devATdbsutdio/watch_hardwares/README.md

# watch_hardwares
PCB files and 3D files from each products and tools designed for the watch project, as exported from fusion360

License: [Apache License](https://github.com/devATdbsutdio/watch_hardwares/blob/main/LICENSE)
