devATdbsutdio/watch_hardwares/watchpcb/README.md

# Main PCB for the LED watch : Version 3

Contains exported CAE design files (schematic & board files) and CAD PCB files from fusion 360.

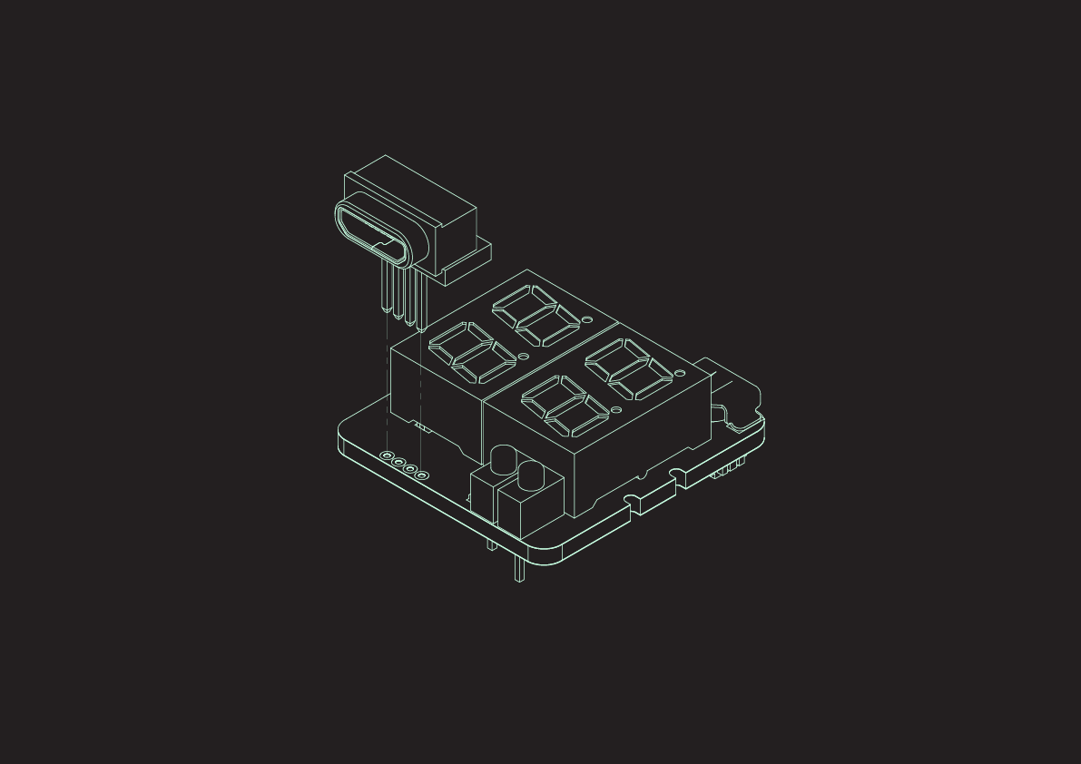
[picture p1: watchpcb/assembly_diagram.png]
assembly


## Special Notes:
* Uses CH343N as serial chip.
* Uses Separate USB module on a Raiser board. 
* Micro usb for Serial port and LiPo charging. 
* UPDI programming pins are broken out in the bottom.
