devATdbsutdio/watch_hardwares/user_programmer/README.md

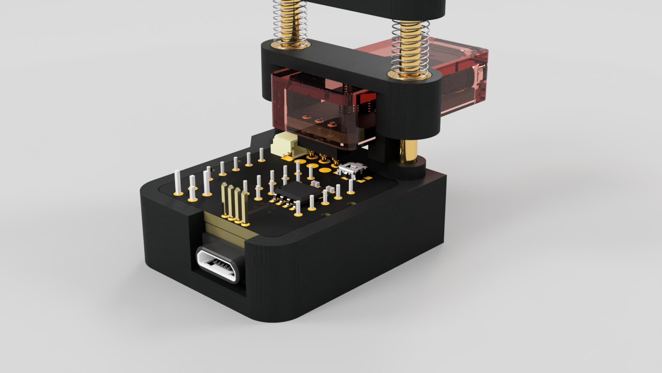
[picture p2: user_programmer/images/firmware_uploader.png]
watchinjig

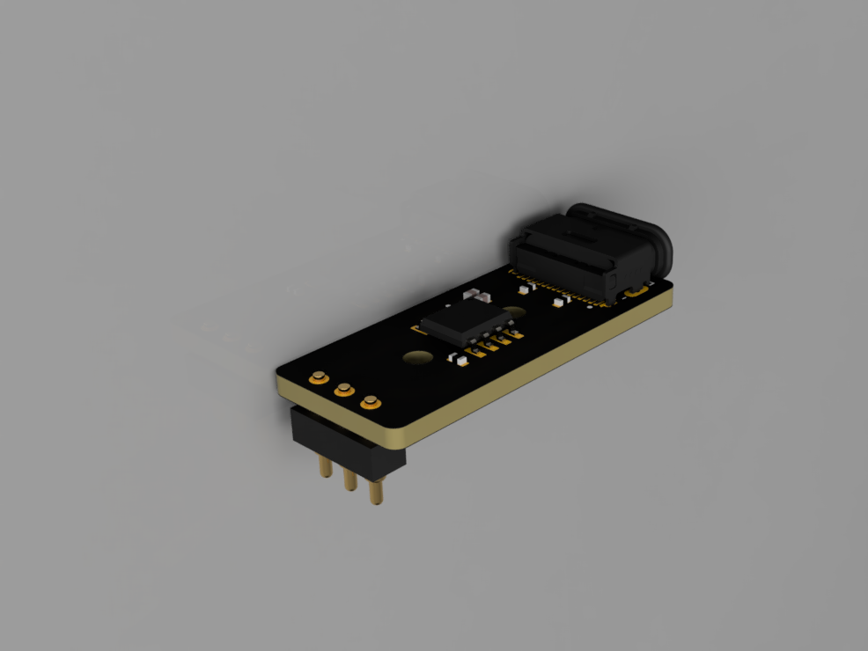
[picture p3: user_programmer/images/user_prog_pcb_top.png]
top

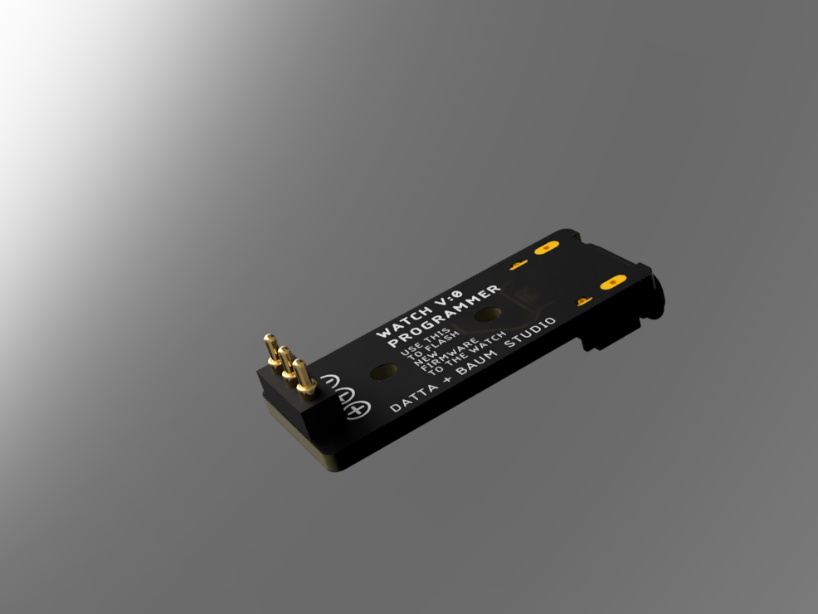
[picture p4: user_programmer/images/user_prog_pcb_bottom.png]
bottom

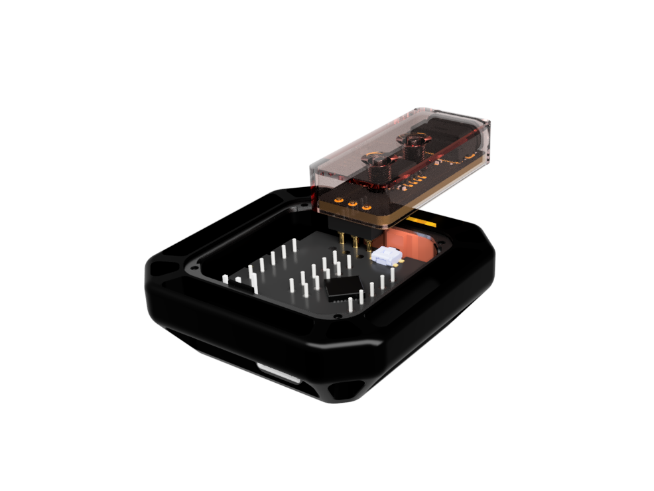
[picture p5: user_programmer/images/prog_on_watch.png]
onwatch
