devATdbsutdio/watch_hardwares/watchpcb/watch_pcb_v3/README.md

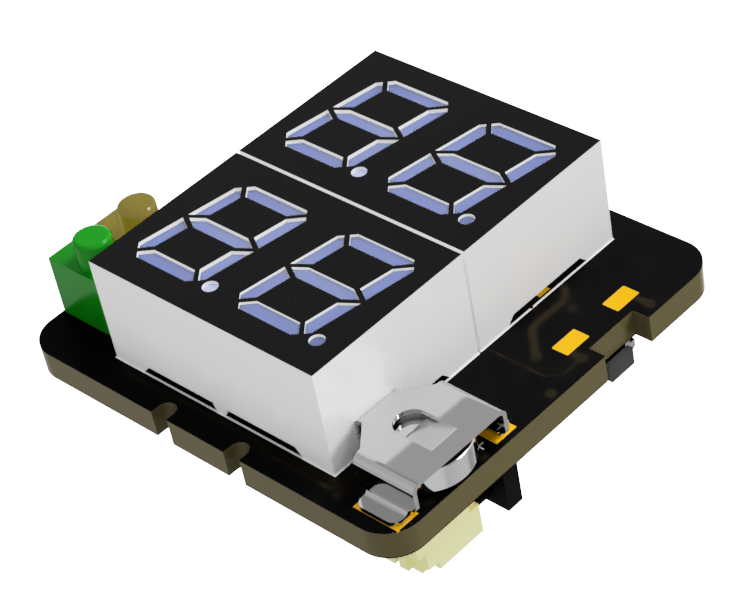
[picture p6: watchpcb/watch_pcb_v3/images/watch_pcb_top_s.png]
top

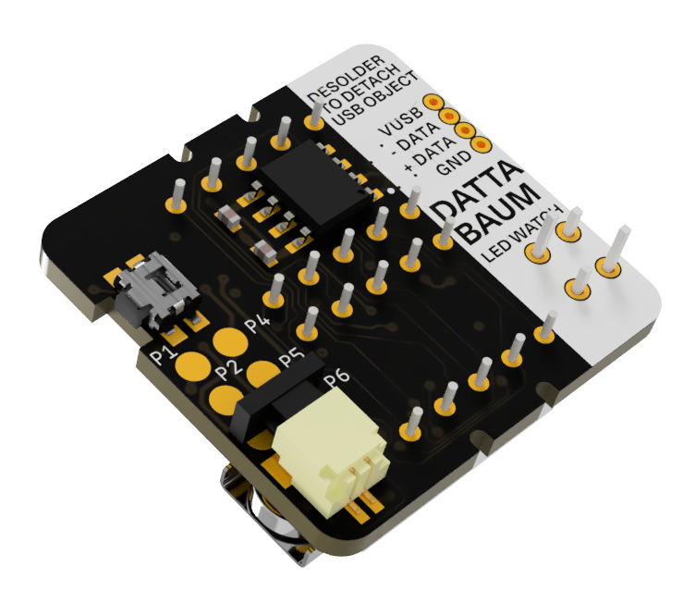
[picture p7: watchpcb/watch_pcb_v3/images/watch_pcb_bottom_s.png]
bottom
