devATdbsutdio/watch_hardwares/watchpcb/raised_usb_module/README.md

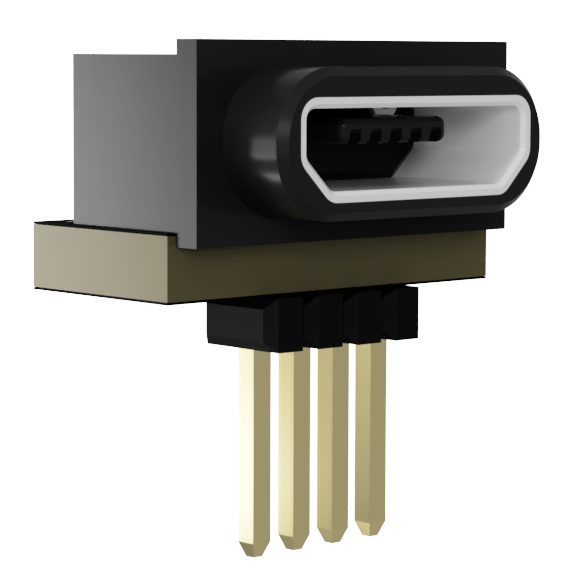
[picture p8: watchpcb/raised_usb_module/images/HOR_water_tight_microUSB_raiser1.png]

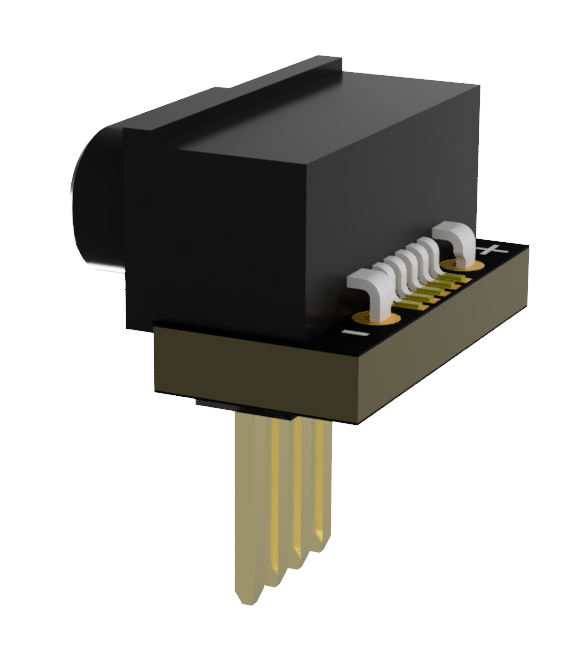
[picture p9: watchpcb/raised_usb_module/images/HOR_water_tight_microUSB_raiser2.png]
