devATdbsutdio/watch_hardwares/user_programmer/images/firmware_uploader_textured.png

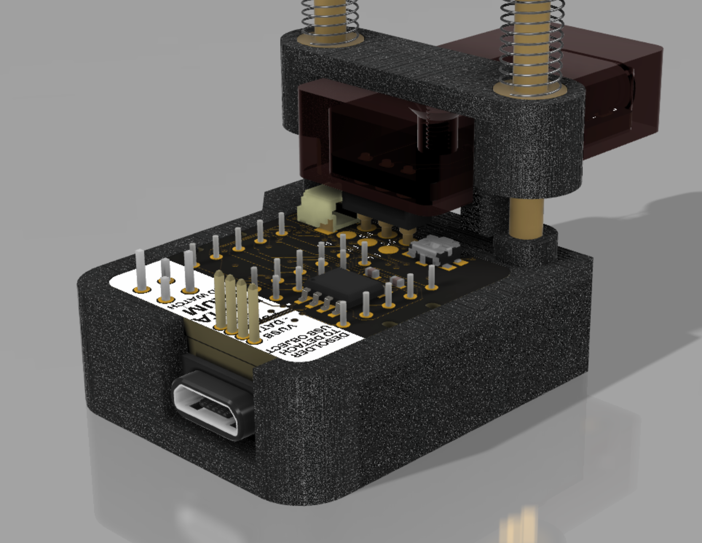
user_programmer/images/firmware_uploader_textured.png
