devATdbsutdio/watch_hardwares/watchpcb/watch_pcb_v3/images/stackup.png

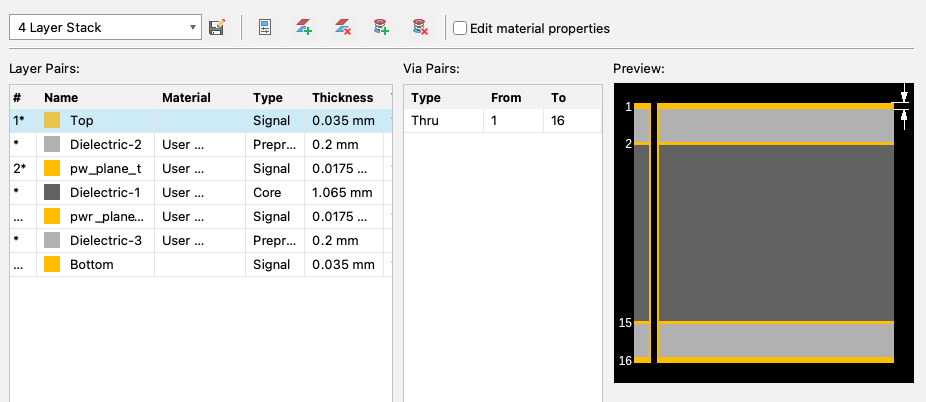
watchpcb/watch_pcb_v3/images/stackup.png
