devATdbsutdio/watch_hardwares/user_programmer/BOM/user_programmer v11.xlsx

user_programmer v11
Part | Value | Device | Package | Description | CATEGORY | MANUFACTURER | MF
C3 | 100nF | C_CHIP-0402 | C0402 | Capacitor - Generic | Capacitor
C4 | 100nF | C_CHIP-0402 | C0402 | Capacitor - Generic | Capacitor
R1 | 4.7K | R-US_CHIP | R0402 | Resistor Fixed - ANSI | Resistor
U$1 | 1X3_POGO_PIN_HOLDER | H093 | 3P-2.5-1.5 | Pogo pins | Pogo | https://item.taobao.com/item.htm?spm=a1z09.2.0.0.85152e8dntbOOL&id=635234737359&_u=42q42hct8c07
U$6 | CH330N | CH330N | SOP-8 | Usb serial chip | Chip
X1 | MICRO_USB | MICRO_USB | SMD | Micro USB Type B Connector - Standard, Shell Through Hole | USB | https://lcsc.com/product-detail/USB-Connectors_Jing-Extension-of-the-Electronic-Co-920-E52A2021S10100_C10418.html
