devATdbsutdio/watch_hardwares/programming_and_testing_jig/3D/LockHinge v2.step

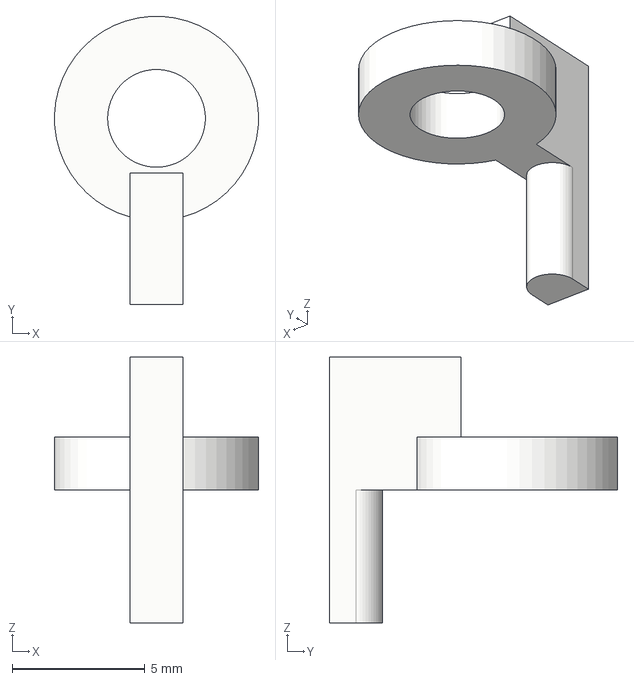
[picture p12: CAD file, 2022-06-01]
programming_and_testing_jig/3D/LockHinge v2.step
7.67 x 10.8 x 10.0 mm
