devATdbsutdio/watch_hardwares/user_programmer/3D/micro_usb_version_prog_shell.step

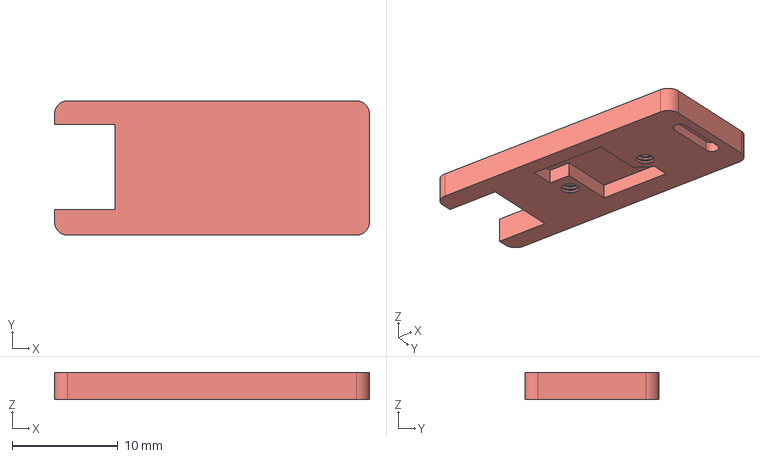
[picture p13: CAD file, 2022-06-10]
user_programmer/3D/micro_usb_version_prog_shell.step
29.7 x 12.7 x 2.55 mm
