devATdbsutdio/watch_hardwares/watchpcb/raised_usb_module/3D/HOR_water_tight_microUSB_raiser.step

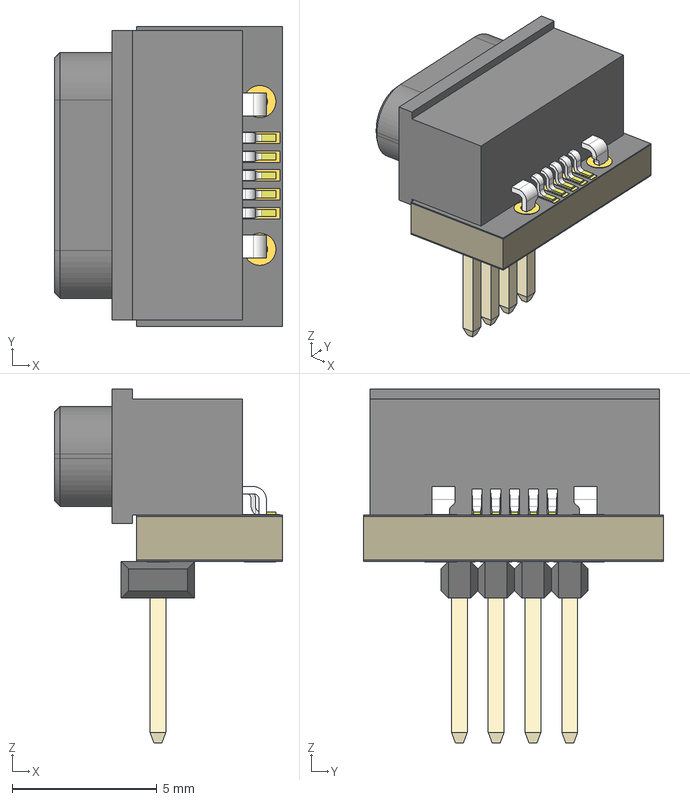
[picture p14: CAD file, 2022-04-22]
watchpcb/raised_usb_module/3D/HOR_water_tight_microUSB_raiser.step
7.89 x 10.4 x 12.2 mm
Board
CUI_DEVICES_UJ2-MIBH-4-SMT-TR-67 v1
1-copper
16-copper
1-soldermask
16-soldermask
