devATdbsutdio/watch_hardwares/package interior foam /box in foam 350x300x130.step

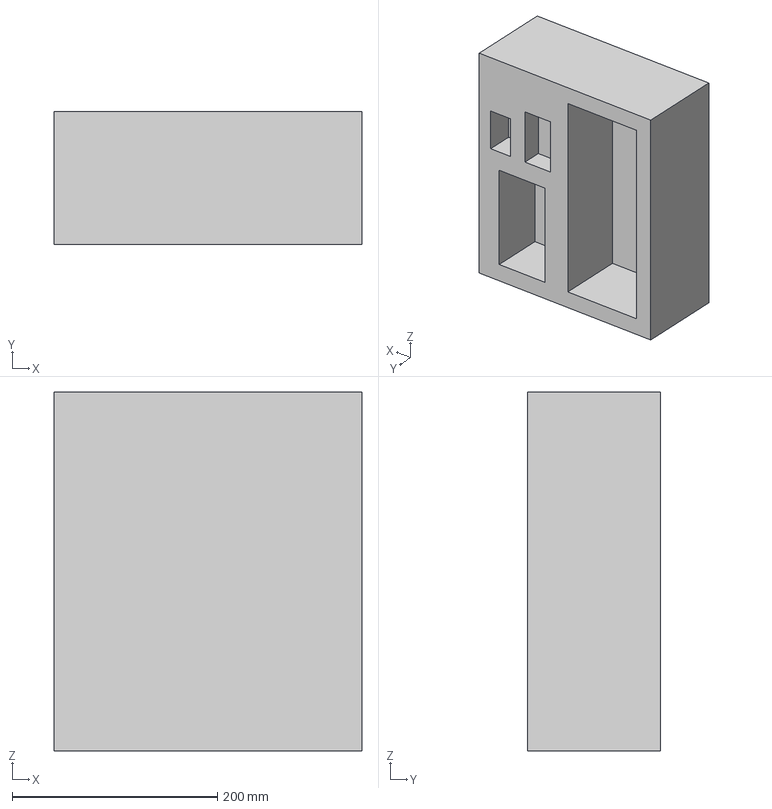
[picture p15: CAD file, 2022-05-25]
package interior foam /box in foam 350x300x130.step
300.0 x 130.0 x 350.0 mm
