devATdbsutdio/watch_hardwares/programming_and_testing_jig/3D/TopFrame v2.step

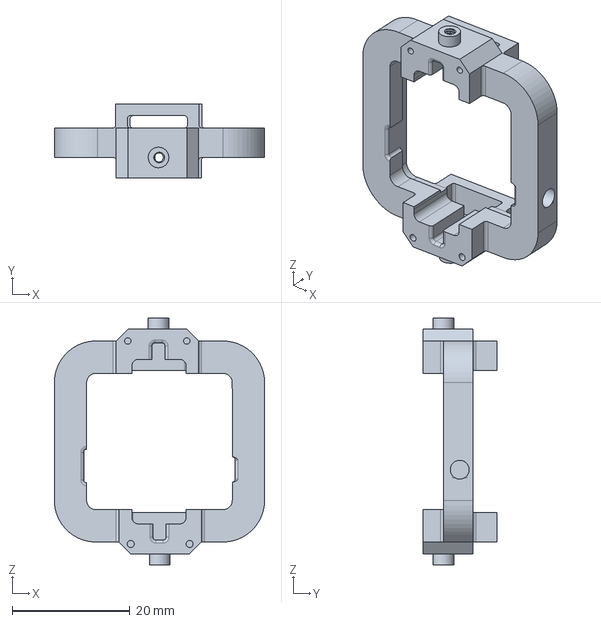
[picture p16: CAD file, 2022-06-01]
programming_and_testing_jig/3D/TopFrame v2.step
35.7 x 12.6 x 41.9 mm
