devATdbsutdio/watch_hardwares/user_programmer/3D/user_programmer_pcb.step

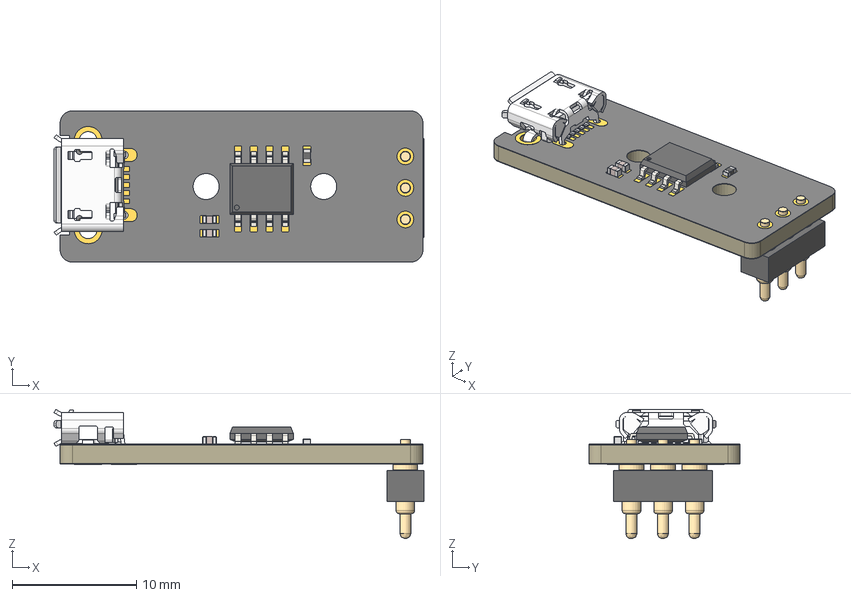
[picture p17: CAD file, 2022-06-04]
user_programmer/3D/user_programmer_pcb.step
29.8 x 12.2 x 10.4 mm
Board
microusb v2
CAPC1005X60 x 2
pogoPin x 3
pinHolder
5576505.f3d
1-copper
16-copper
1-soldermask
16-soldermask
