devATdbsutdio/watch_hardwares/user_programmer/3D/user_prog_pcb.step

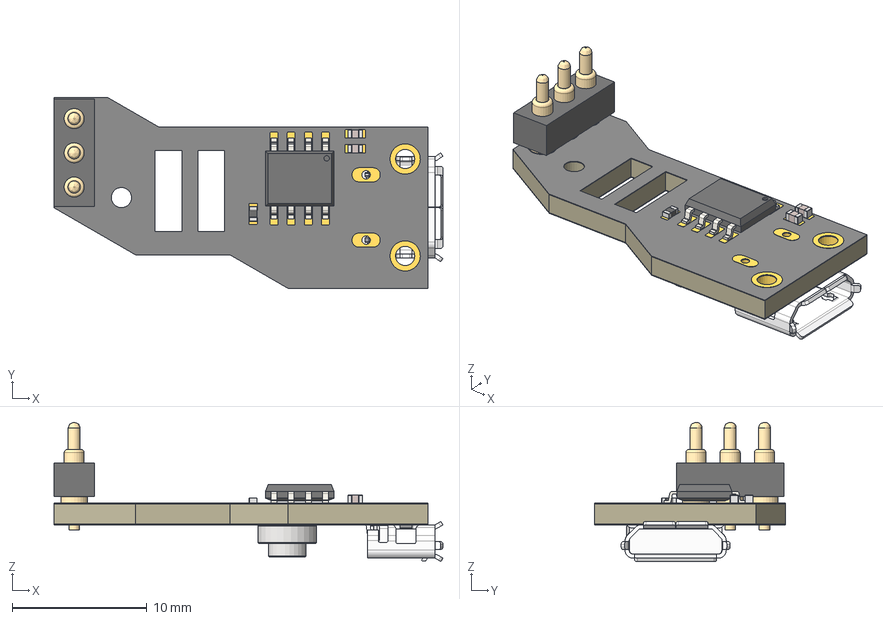
[picture p18: CAD file, 2022-04-21]
user_programmer/3D/user_prog_pcb.step
28.9 x 14.2 x 10.3 mm
Board
1-soldermask
16-soldermask
M2X2.4SMT_STANDOFF
CAPC1005X60 x 2
pogoPin x 3
pinHolder
microusb v2
5576505.f3d
1-copper
16-copper
