devATdbsutdio/watch_hardwares/programming_and_testing_jig/3D/Base.step

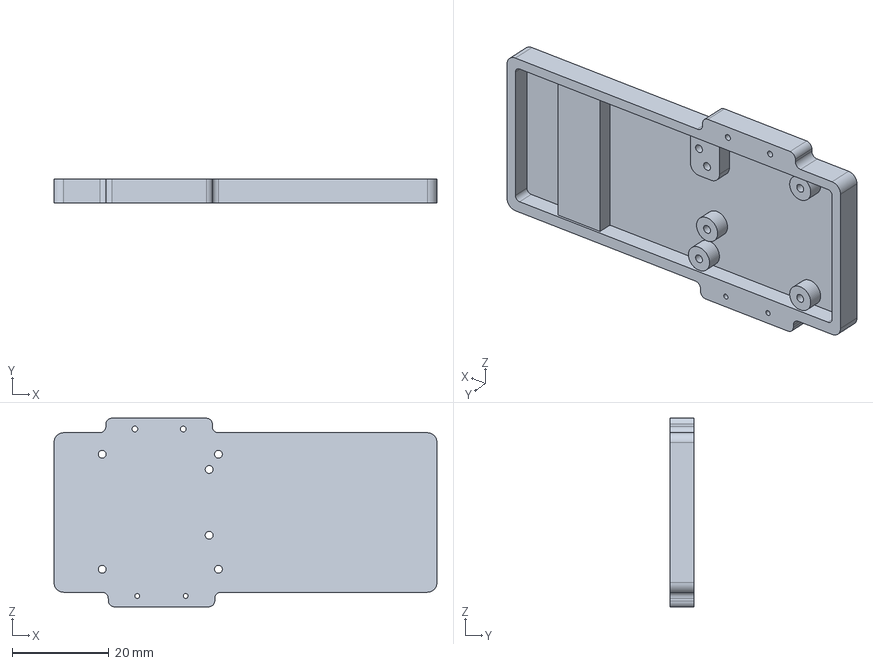
[picture p19: CAD file, 2022-05-26]
programming_and_testing_jig/3D/Base.step
79.1 x 5.00 x 38.9 mm
