devATdbsutdio/watch_hardwares/programming_and_testing_jig/3D/LockHinge.step

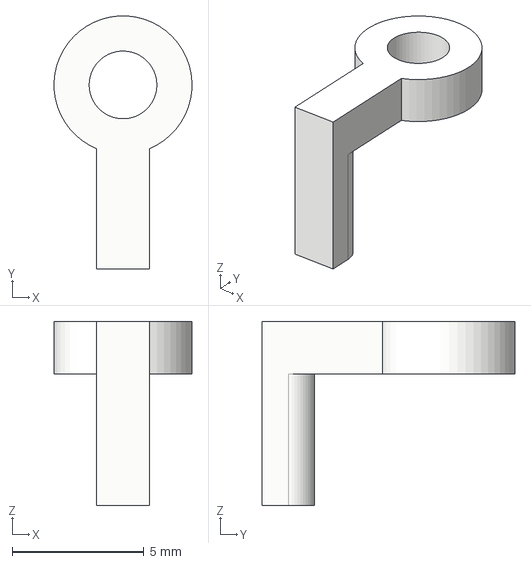
[picture p20: CAD file, 2022-05-26, an earlier design]
programming_and_testing_jig/3D/LockHinge.step
5.25 x 9.62 x 7.00 mm
