devATdbsutdio/watch_hardwares/programming_and_testing_jig/3D/TopFrame.step

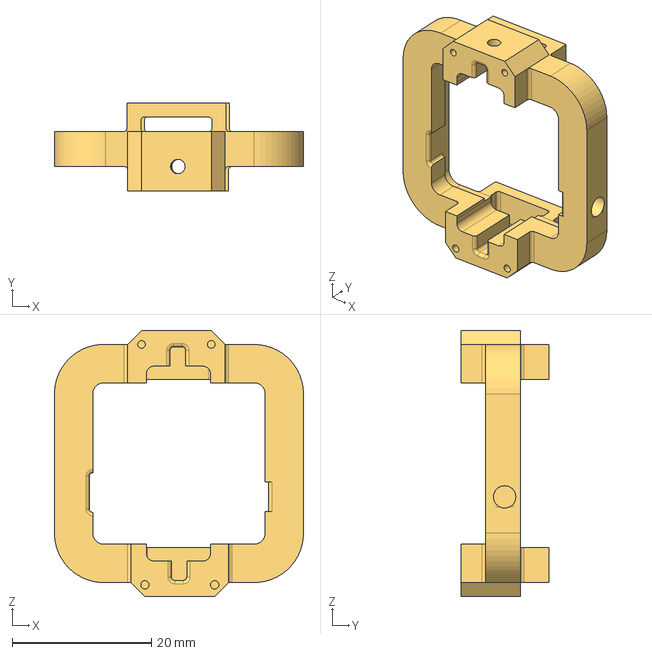
[picture p21: CAD file, 2022-05-26, an earlier design]
programming_and_testing_jig/3D/TopFrame.step
35.7 x 12.6 x 38.1 mm
