devATdbsutdio/watch_hardwares/(list of files, cad)

Other CAD files:
package interior foam /box in foam 350x300x130.dxf
package interior foam /foam PCB tray.dxf
programming_and_testing_jig/3D/BottmTopFrame v2.f3d
programming_and_testing_jig/3D/LockHinge v2.f3d
programming_and_testing_jig/3D/testing_jig_PCB.f3z
programming_and_testing_jig/3D/testing_jig_assembly.f3z
user_programmer/3D/HOUSING.f3d
user_programmer/3D/micro_usb_version_prog_shell.f3d
user_programmer/3D/user_prog_pcb_shell.f3d
user_programmer/3D/user_programmer_pcb.f3d
watchpcb/raised_usb_module/3D/HOR_water_tight_microUSB_raiser.f3d
