devATdbsutdio/watch_hardwares/ASSEMBLY GUIDE FOR MANUFACTURER/For ID assembler (some pcb components)/Untitled.pdf

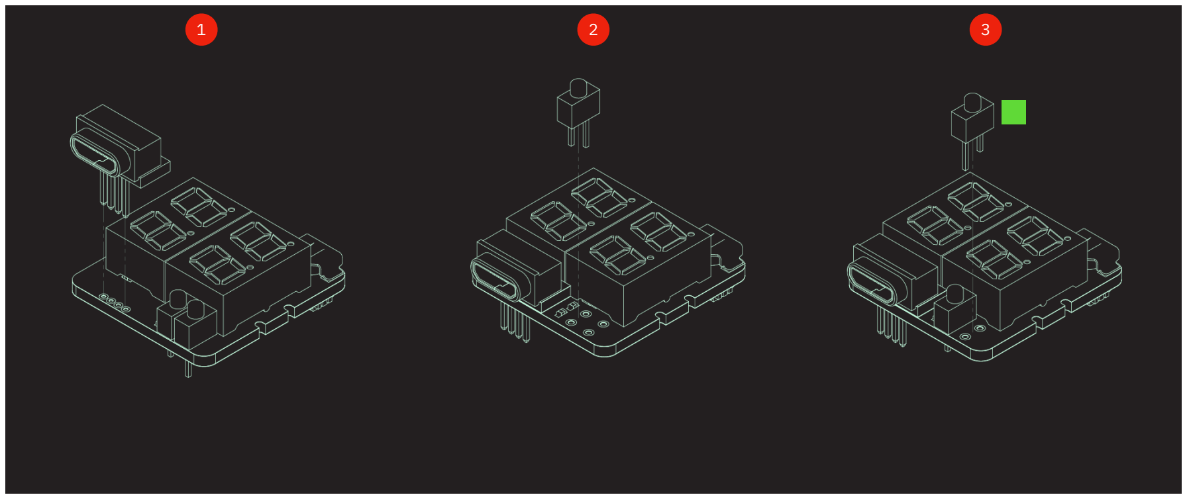
[picture p35: page 1]

1 | 2 | 3

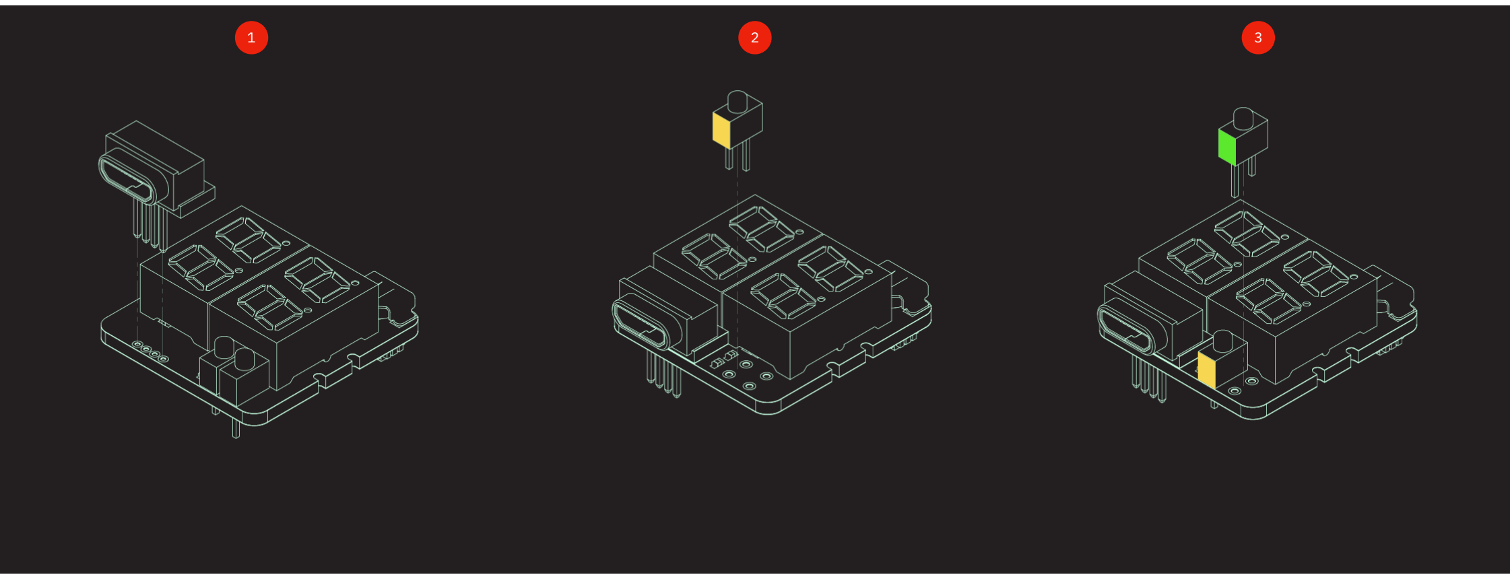
[picture p36: page 2]

1 | 2 | 3
