devATdbsutdio/watch_hardwares/ASSEMBLY GUIDE FOR MANUFACTURER/For ID assembler (some pcb components)/assembly_diagram_2.png

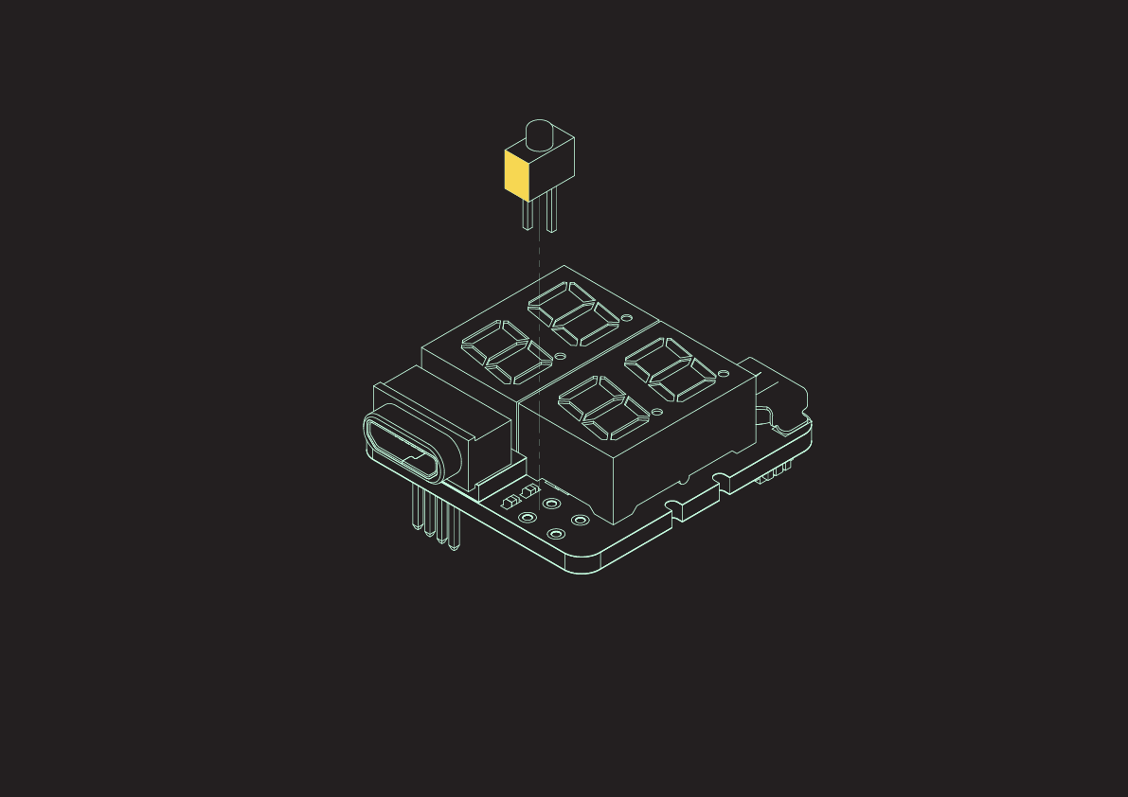
ASSEMBLY GUIDE FOR MANUFACTURER/For ID assembler (some pcb components)/assembly_diagram_2.png
