devATdbsutdio/watch_hardwares/programming_and_testing_jig/README.md

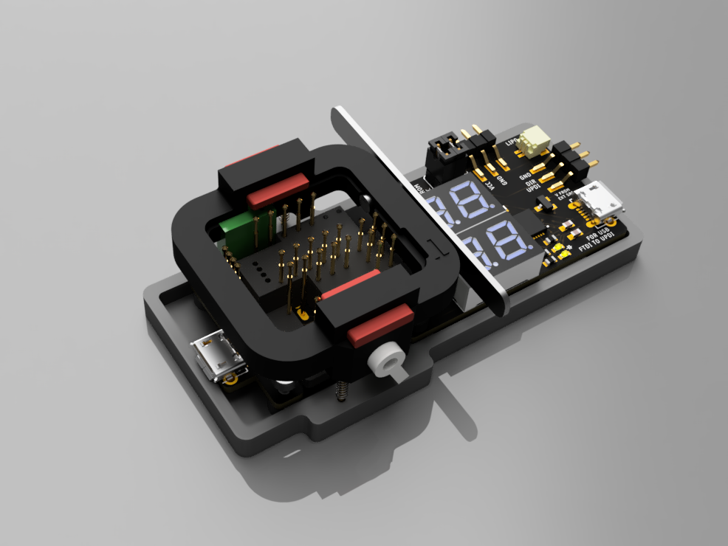
[picture p38: programming_and_testing_jig/images/component_jig_assembled.png]
top view

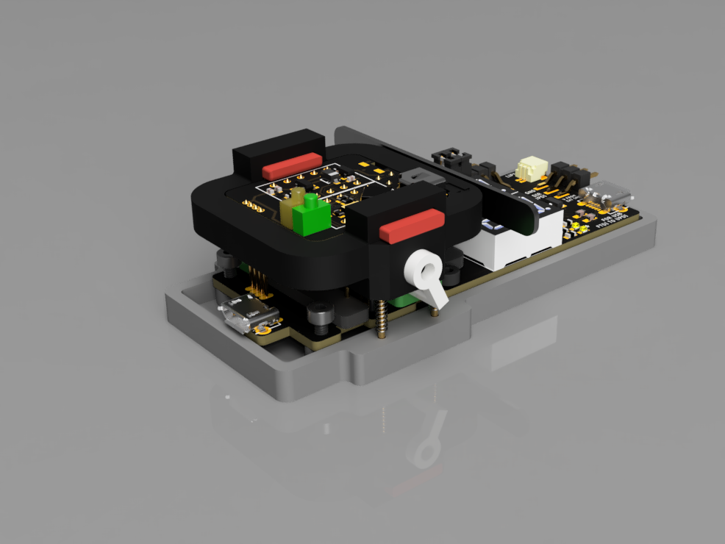
[picture p39: programming_and_testing_jig/images/assembled_test_jig_view_1.png]
side view
