devATdbsutdio/watch_hardwares/programming_and_testing_jig/images/side_view.png

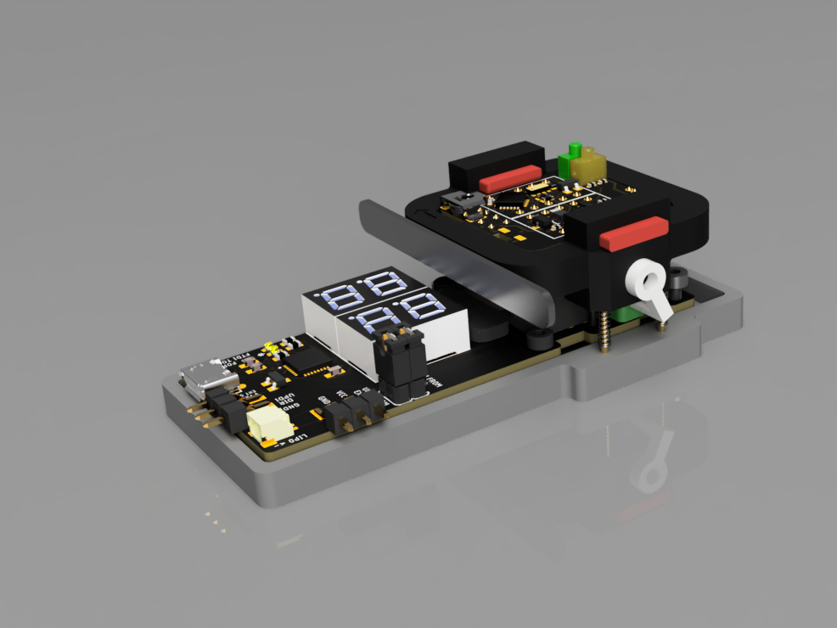
programming_and_testing_jig/images/side_view.png
