devATdbsutdio/watch_hardwares/watchpcb/assembly_diagram.pdf

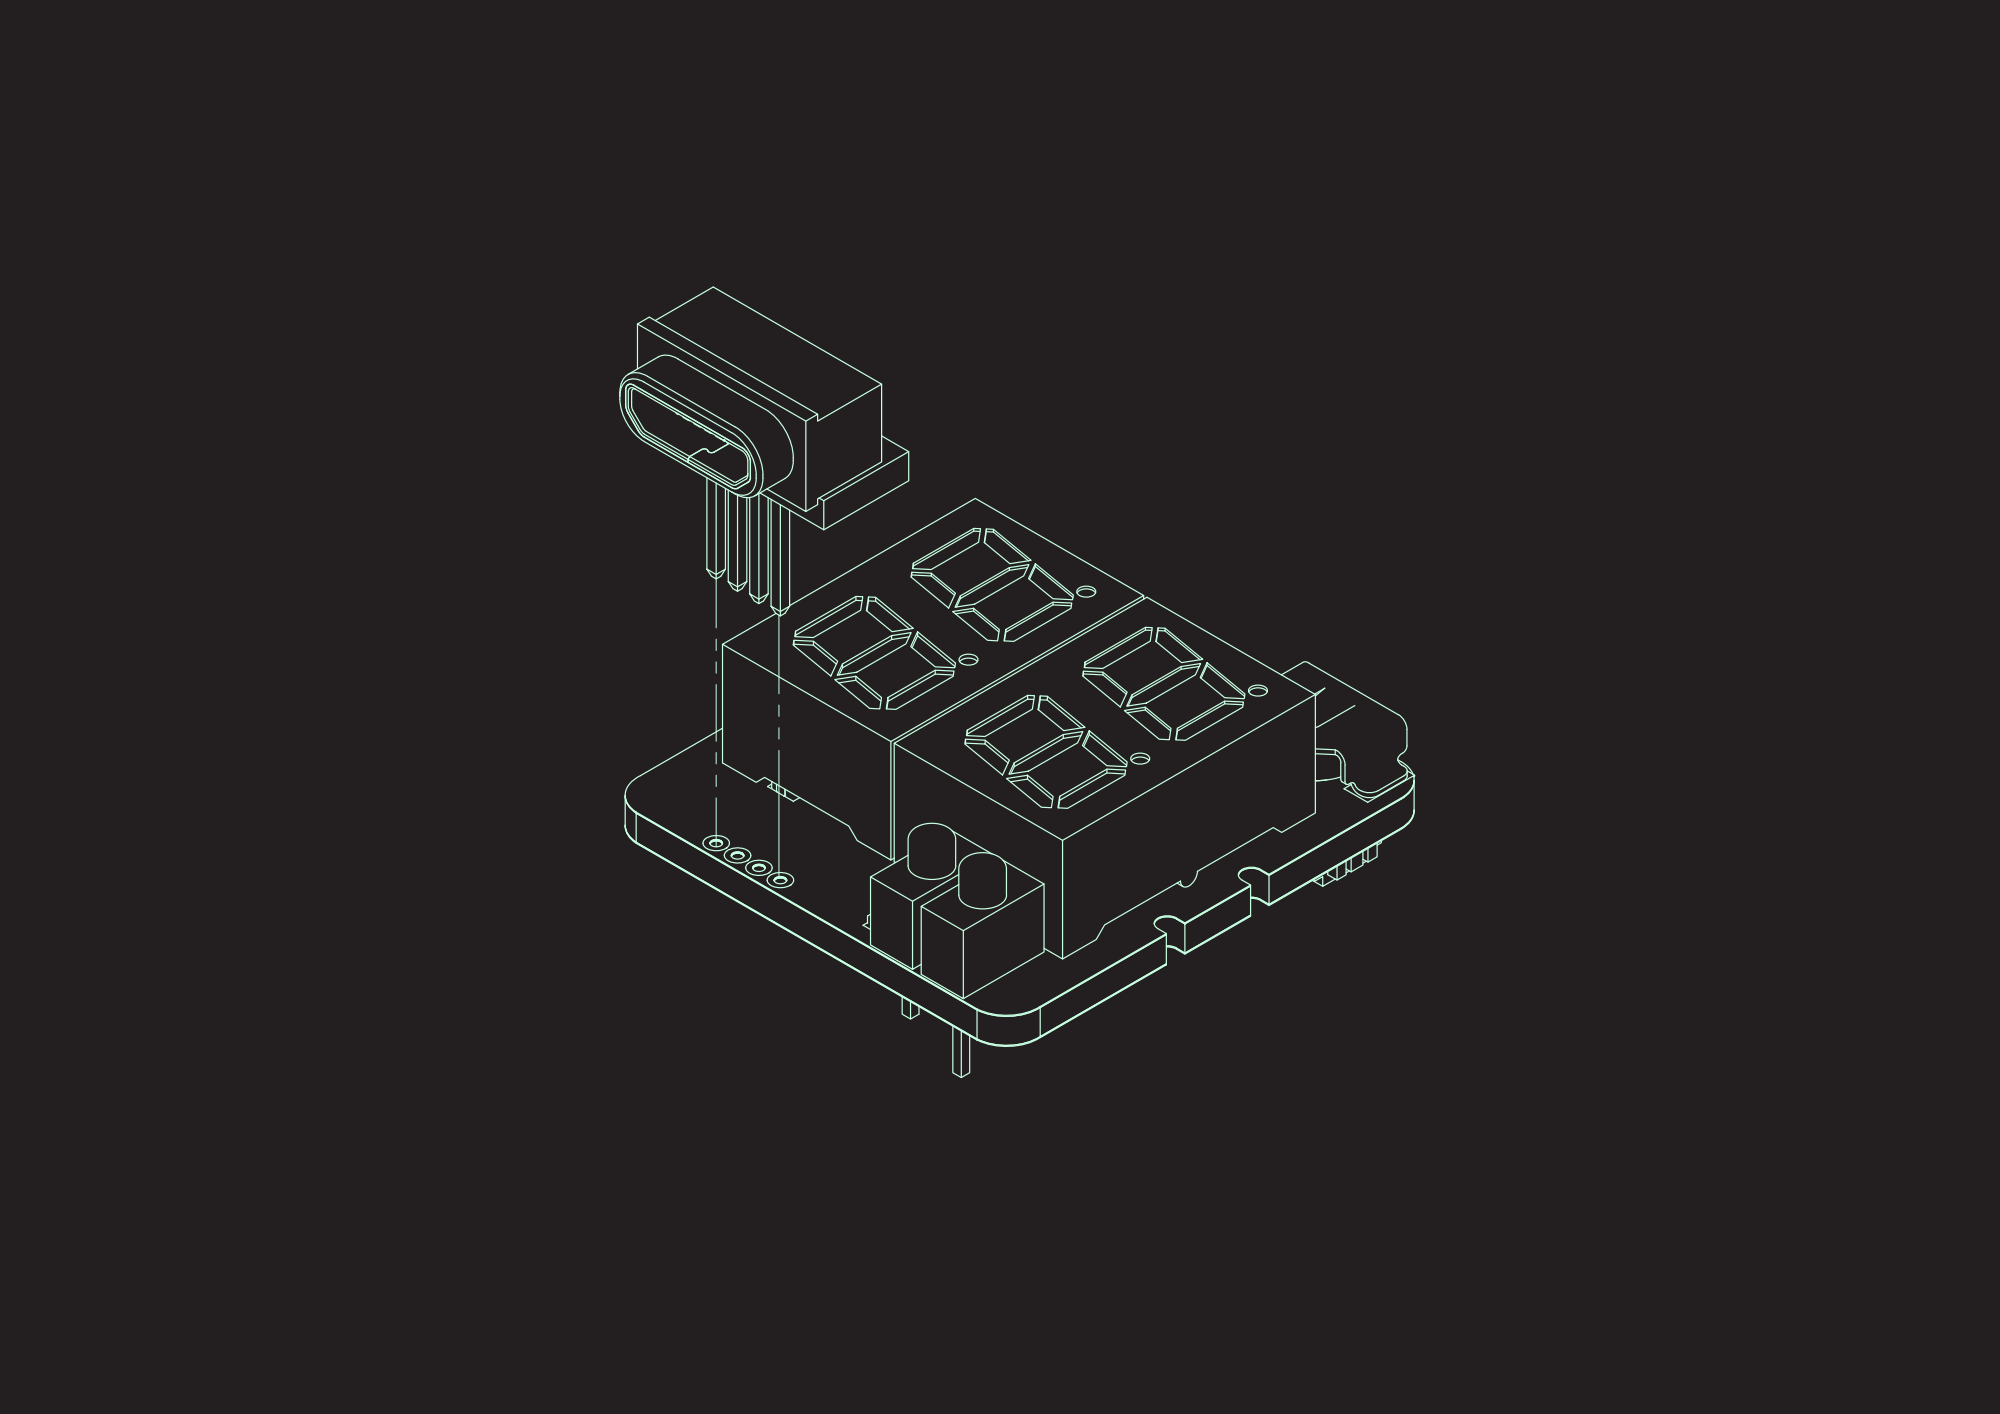
[picture p41: page 1]
