devATdbsutdio/watch_hardwares/ASSEMBLY GUIDE FOR MANUFACTURER/For ID assembler (some pcb components)/assembly1.pdf

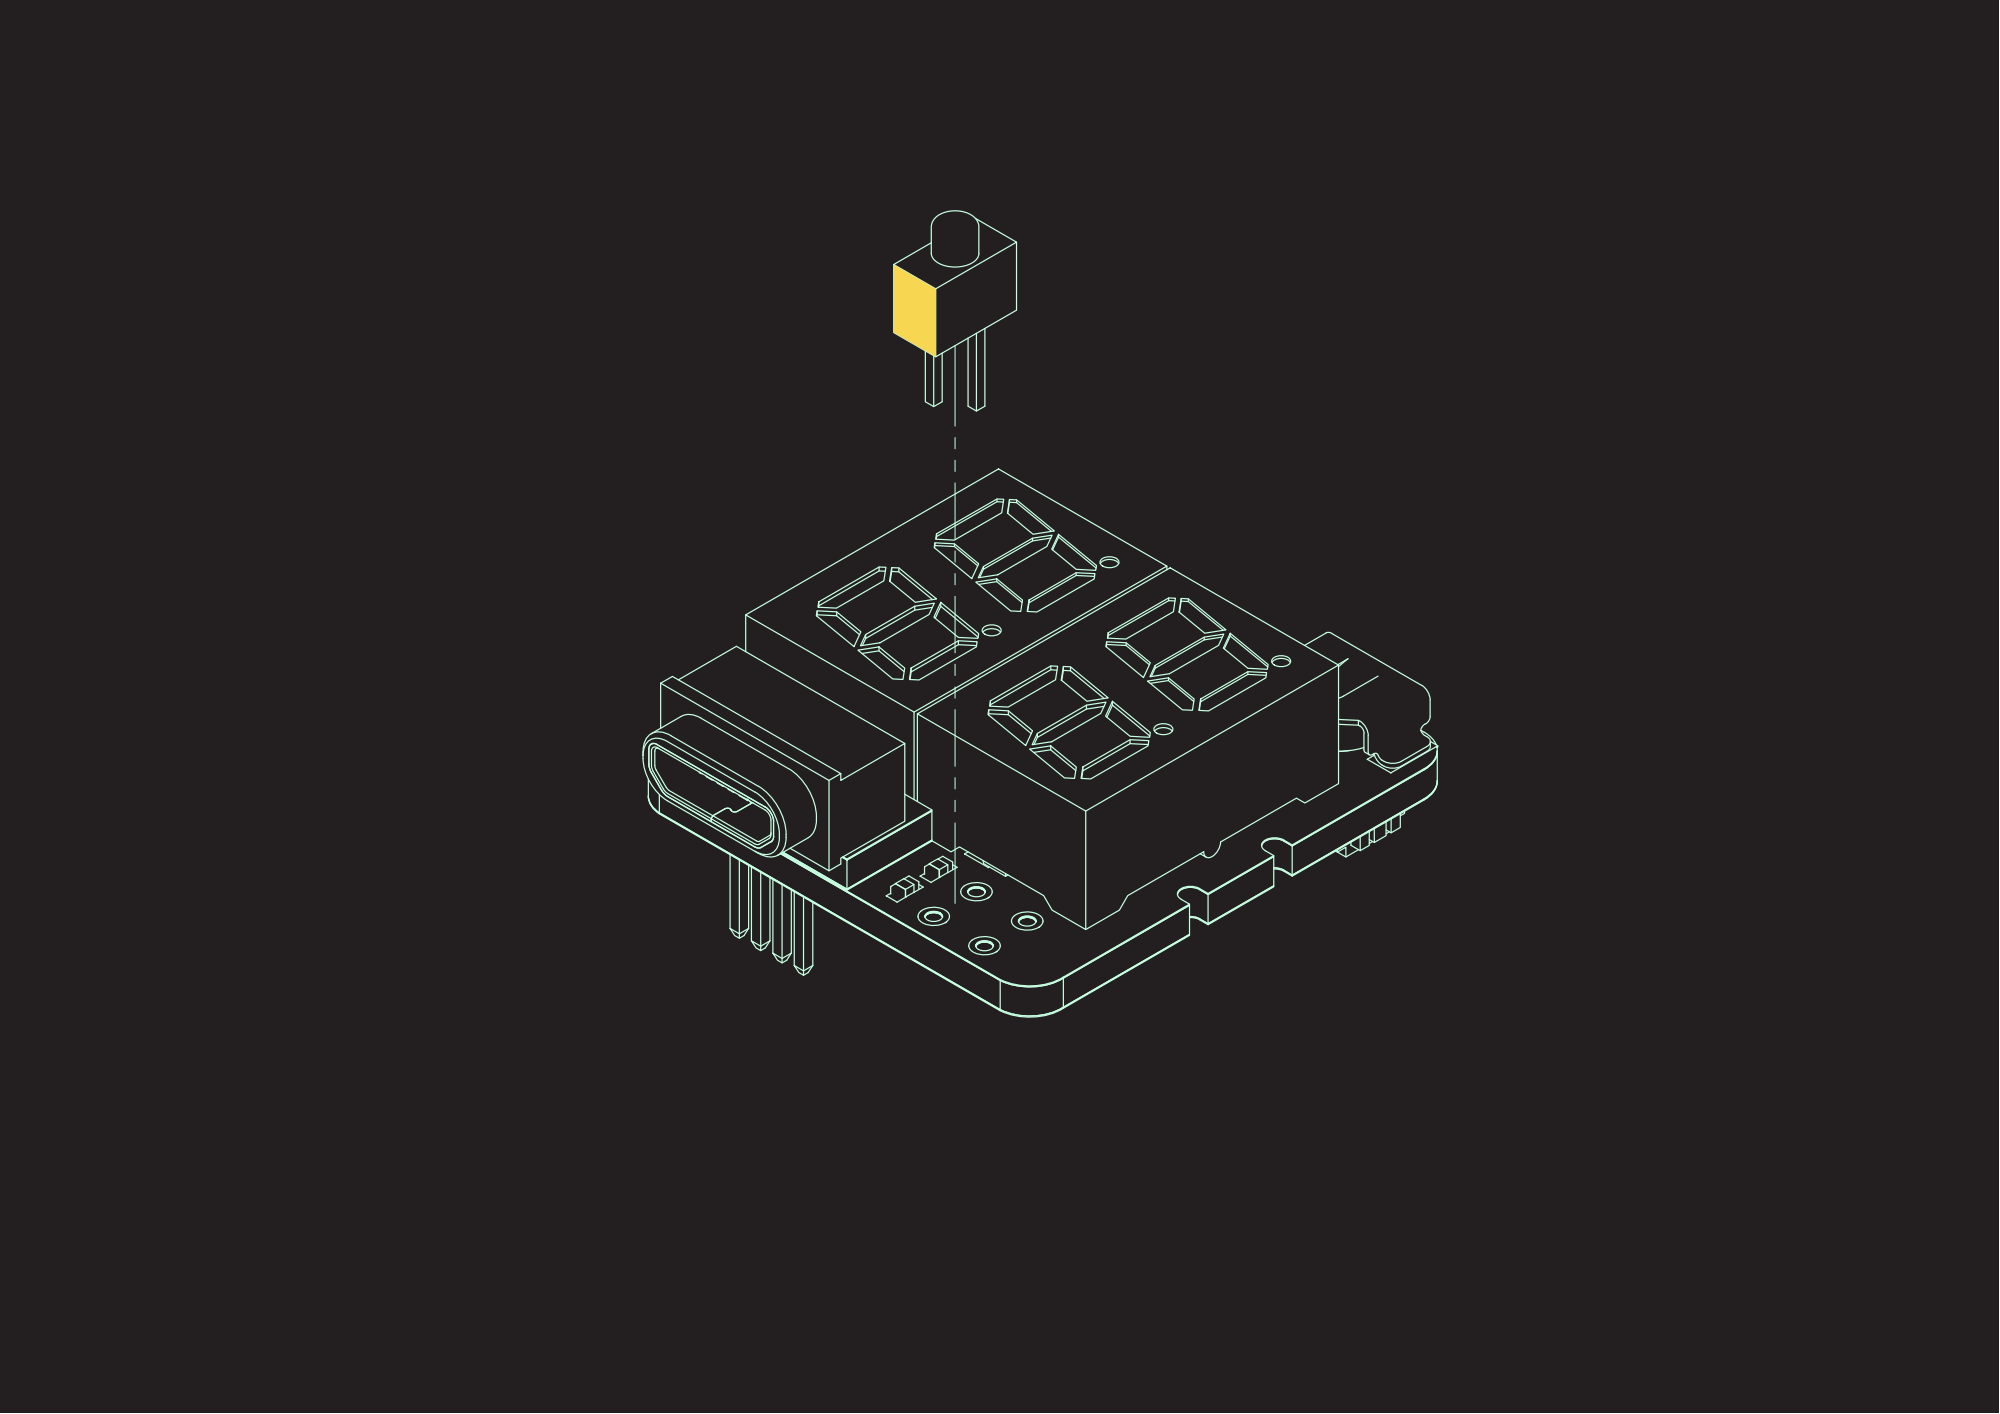
[picture p42: page 1]
