devATdbsutdio/watch_hardwares/ASSEMBLY GUIDE FOR MANUFACTURER/For ID assembler (some pcb components)/assembly2.pdf

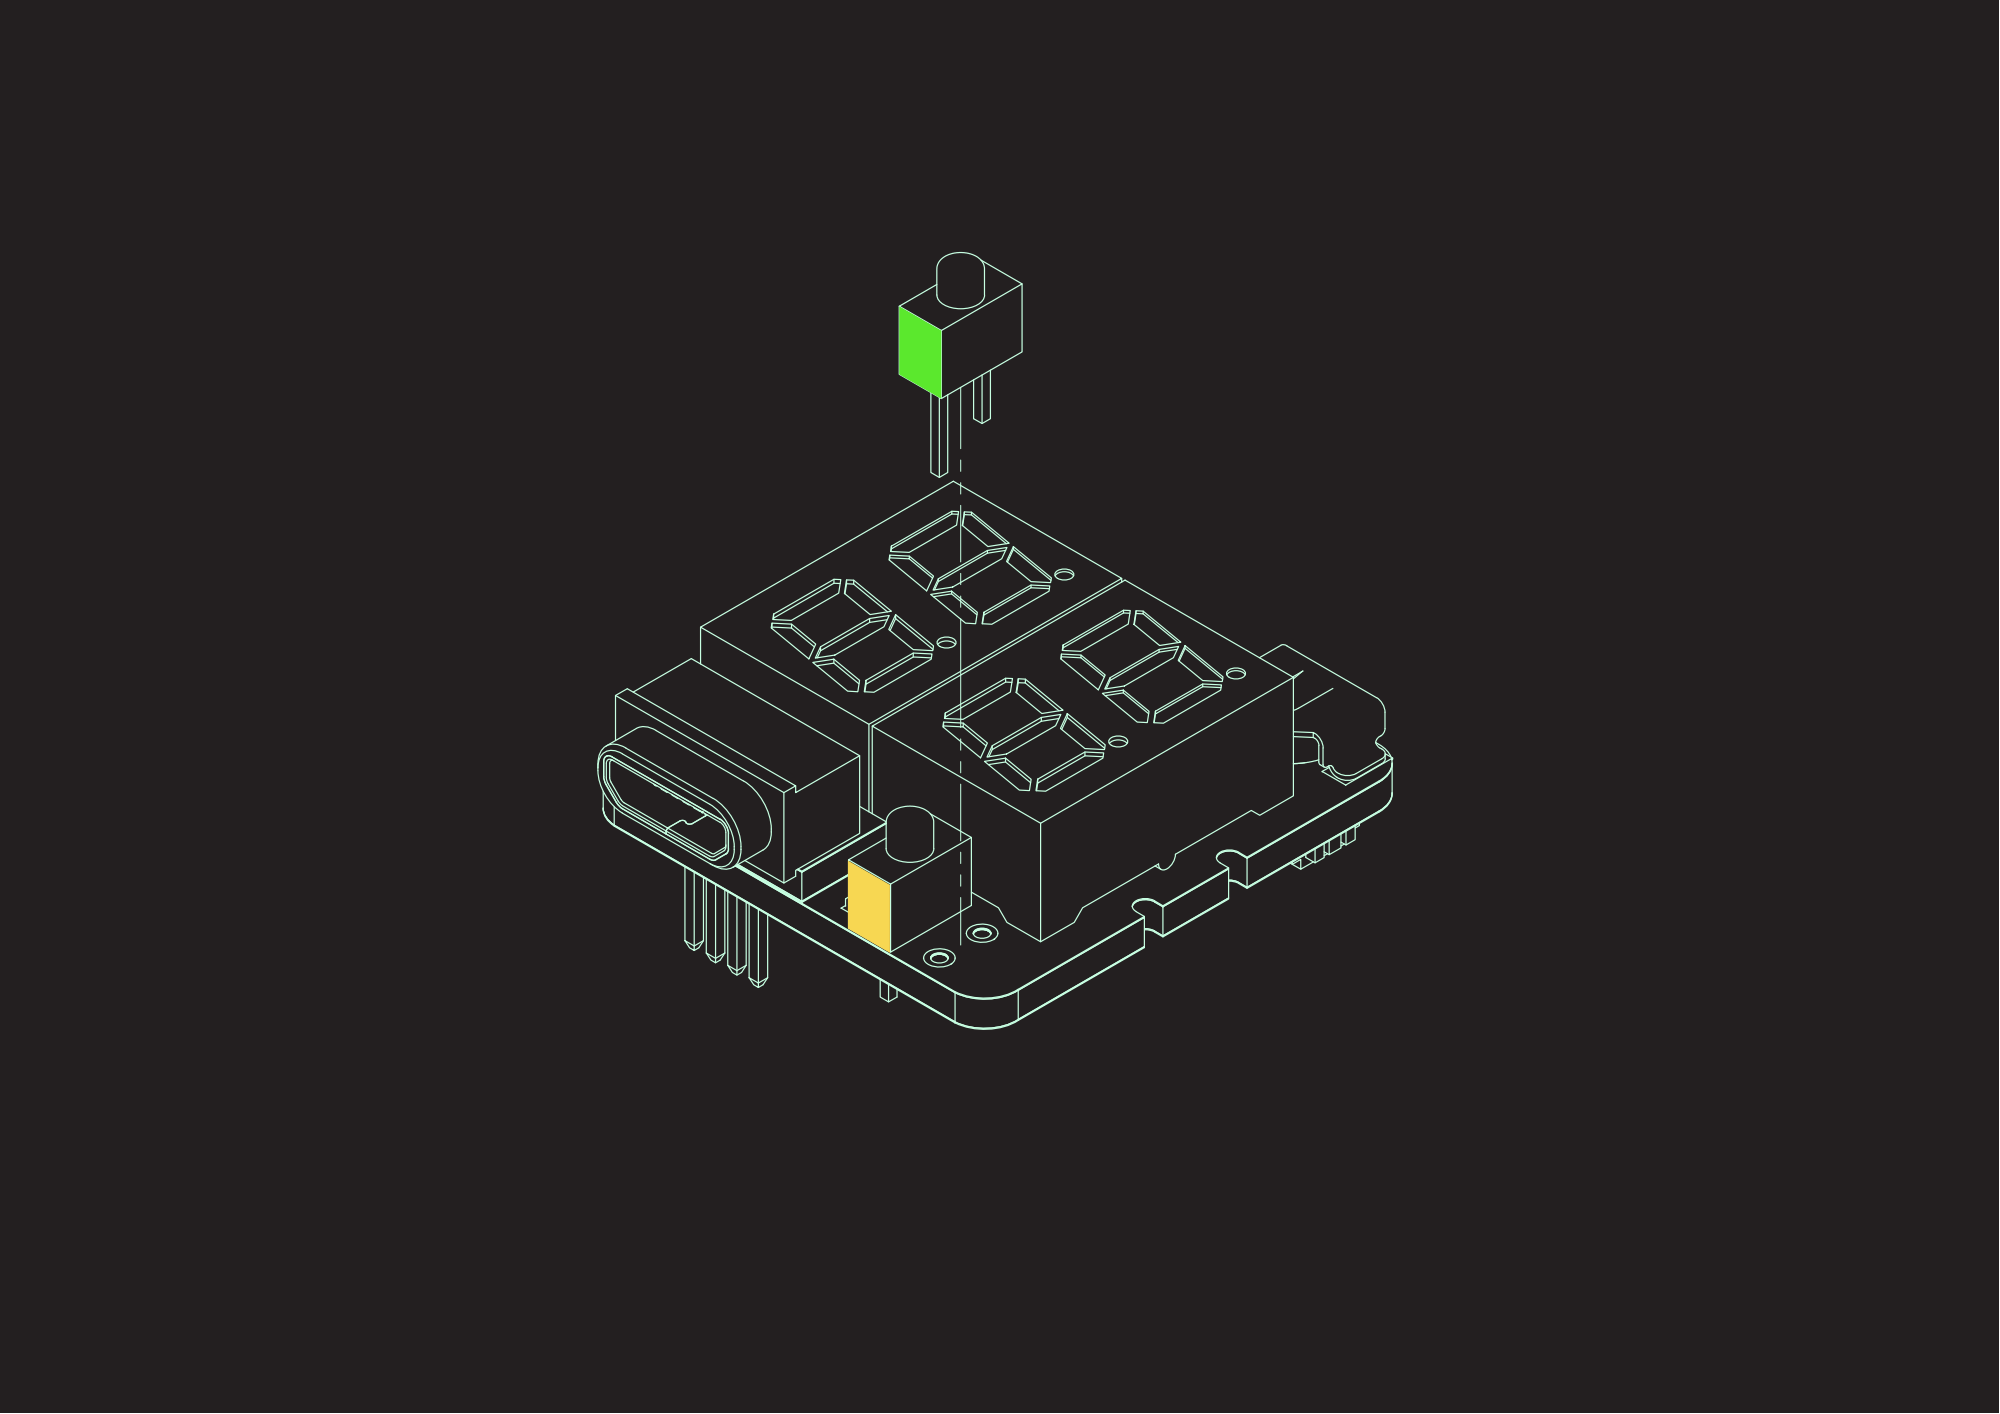
[picture p43: page 1]
