devATdbsutdio/watch_hardwares/watchpcb/watch_pcb_v3/PnP/watch_pcb_bom.pdf

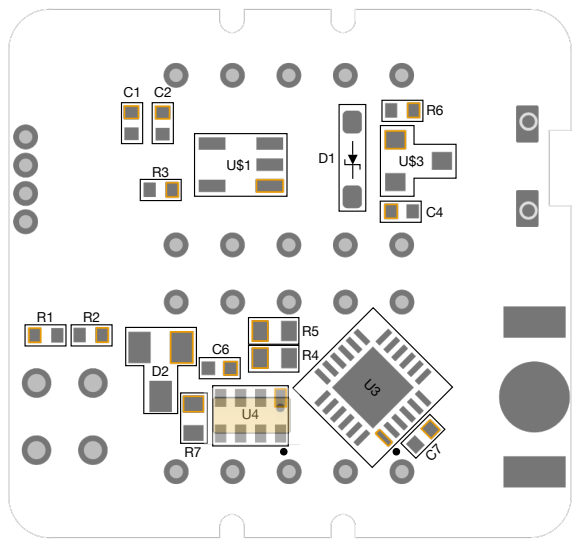
[picture p44: page 1]

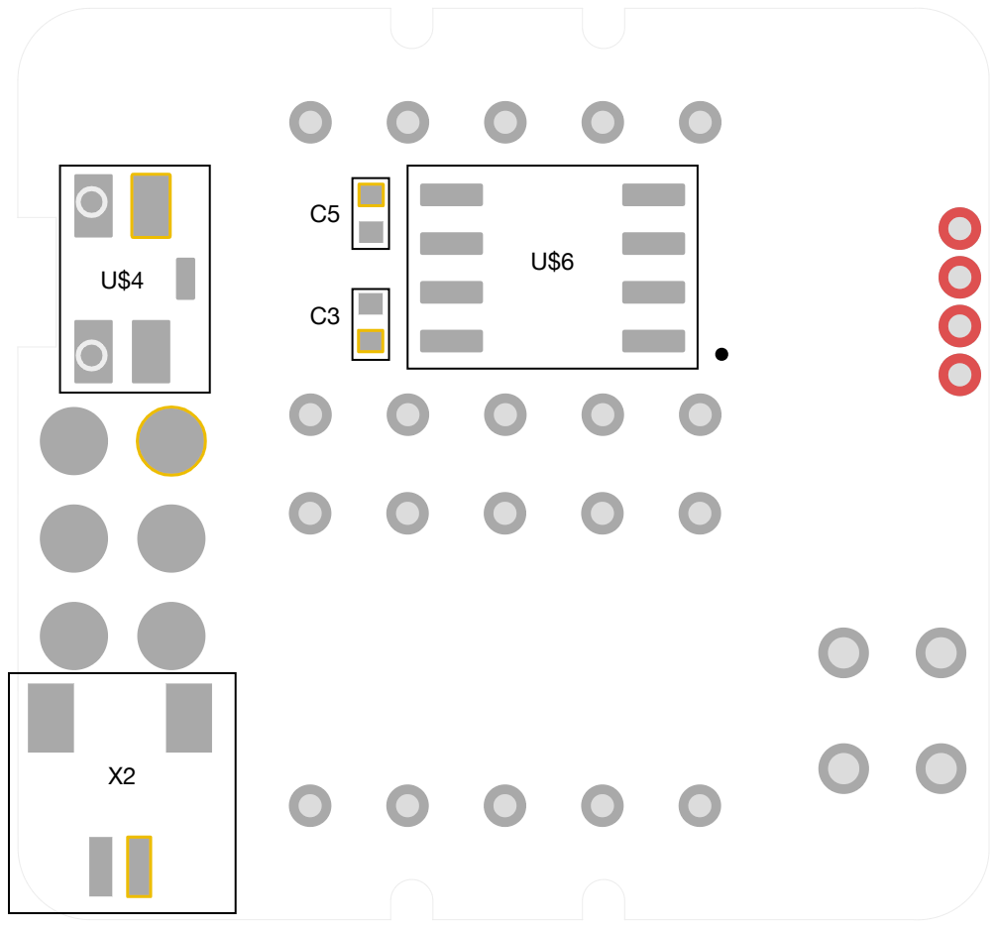
[picture p45: page 2]

U$6 U$4

X2

C5

C3
