devATdbsutdio/watch_hardwares/user_programmer/PCB_Board/user_prog_jig_pcb_v206.brd

## EAGLE design user_programmer/PCB_Board/user_prog_jig_pcb_v206.brd (2022-05-25)

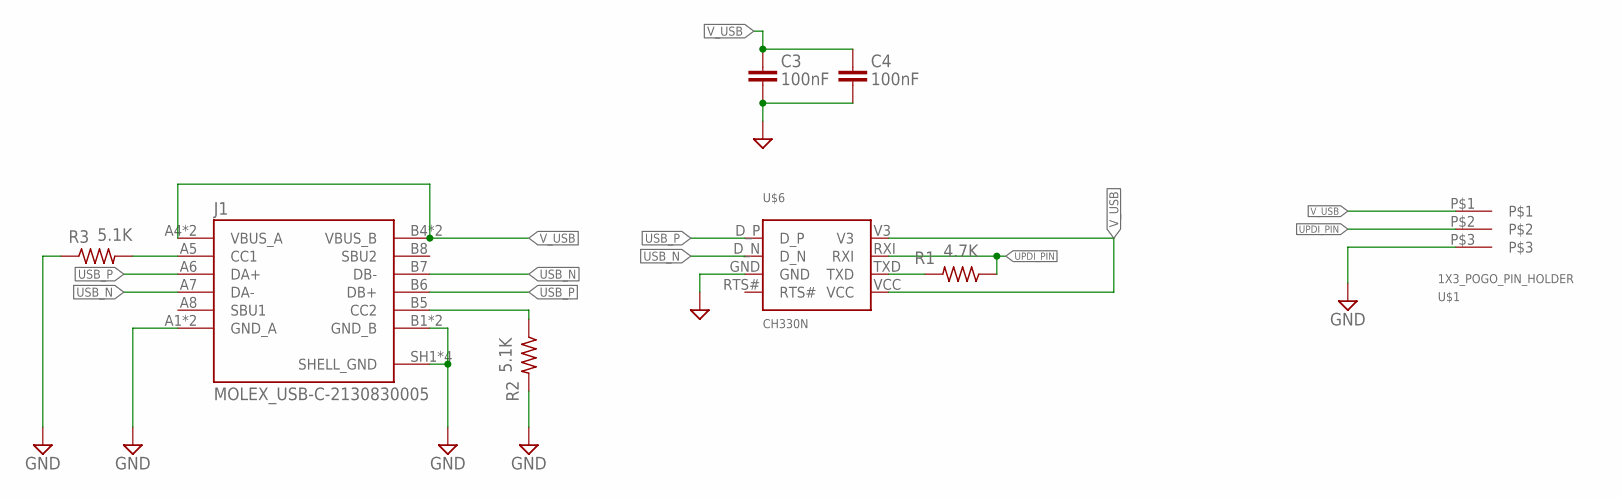
[picture p49: schematic user_prog_jig_pcb v64.sch]

Parts:
C3, C4: 100nF; CAPC1005X60
J1: MOLEX_USB-C-2130830005; MOLEX_2130830005
R1: 4.7K; RESC1005X40
R2, R3: 5.1K; RESC1005X40
U$1: 1X3_POGO_PIN_HOLDER
U$6: CH330N

Connections:
CC1: J1.A5 (CC1), R3.2
CC2: J1.B5 (CC2), R2.1
GND: C3.2, C4.2, J1.A1 (GND_A), J1.A12 (GND_A), J1.B1 (GND_B), J1.B12 (GND_B), J1.SH1 (SHELL_GND), J1.SH2 (SHELL_GND), J1.SH3 (SHELL_GND), J1.SH4 (SHELL_GND), R2.2, R3.1, U$1.P$3, U$6.GND
unnamed: R1.2, U$6.TXD
UPDI_PIN: R1.1, U$1.P$2, U$6.RXI
USB_N: J1.A7 (DA-), J1.B7 (DB-), U$6.D_N
USB_P: J1.A6 (DA+), J1.B6 (DB+), U$6.D_P
V_USB: C3.1, C4.1, J1.A4 (VBUS_A), J1.A9 (VBUS_A), J1.B4 (VBUS_B), J1.B9 (VBUS_B), U$1.P$1, U$6.V3, U$6.VCC

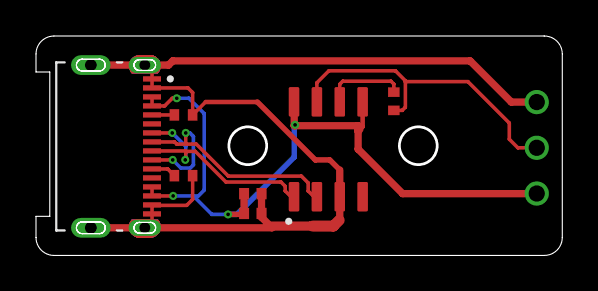
[picture p50: board user_prog_jig_pcb_v206.brd from above]

Board: 2 copper layers, 29.2 x 12.2 mm, 8 parts (1 on the bottom side), 8 nets.
