devATdbsutdio/watch_hardwares/watchpcb/watch_pcb_v3/PCB_Board/watch_pcb.brd

## EAGLE design watchpcb/watch_pcb_v3/PCB_Board/watch_pcb.brd (2022-04-22)

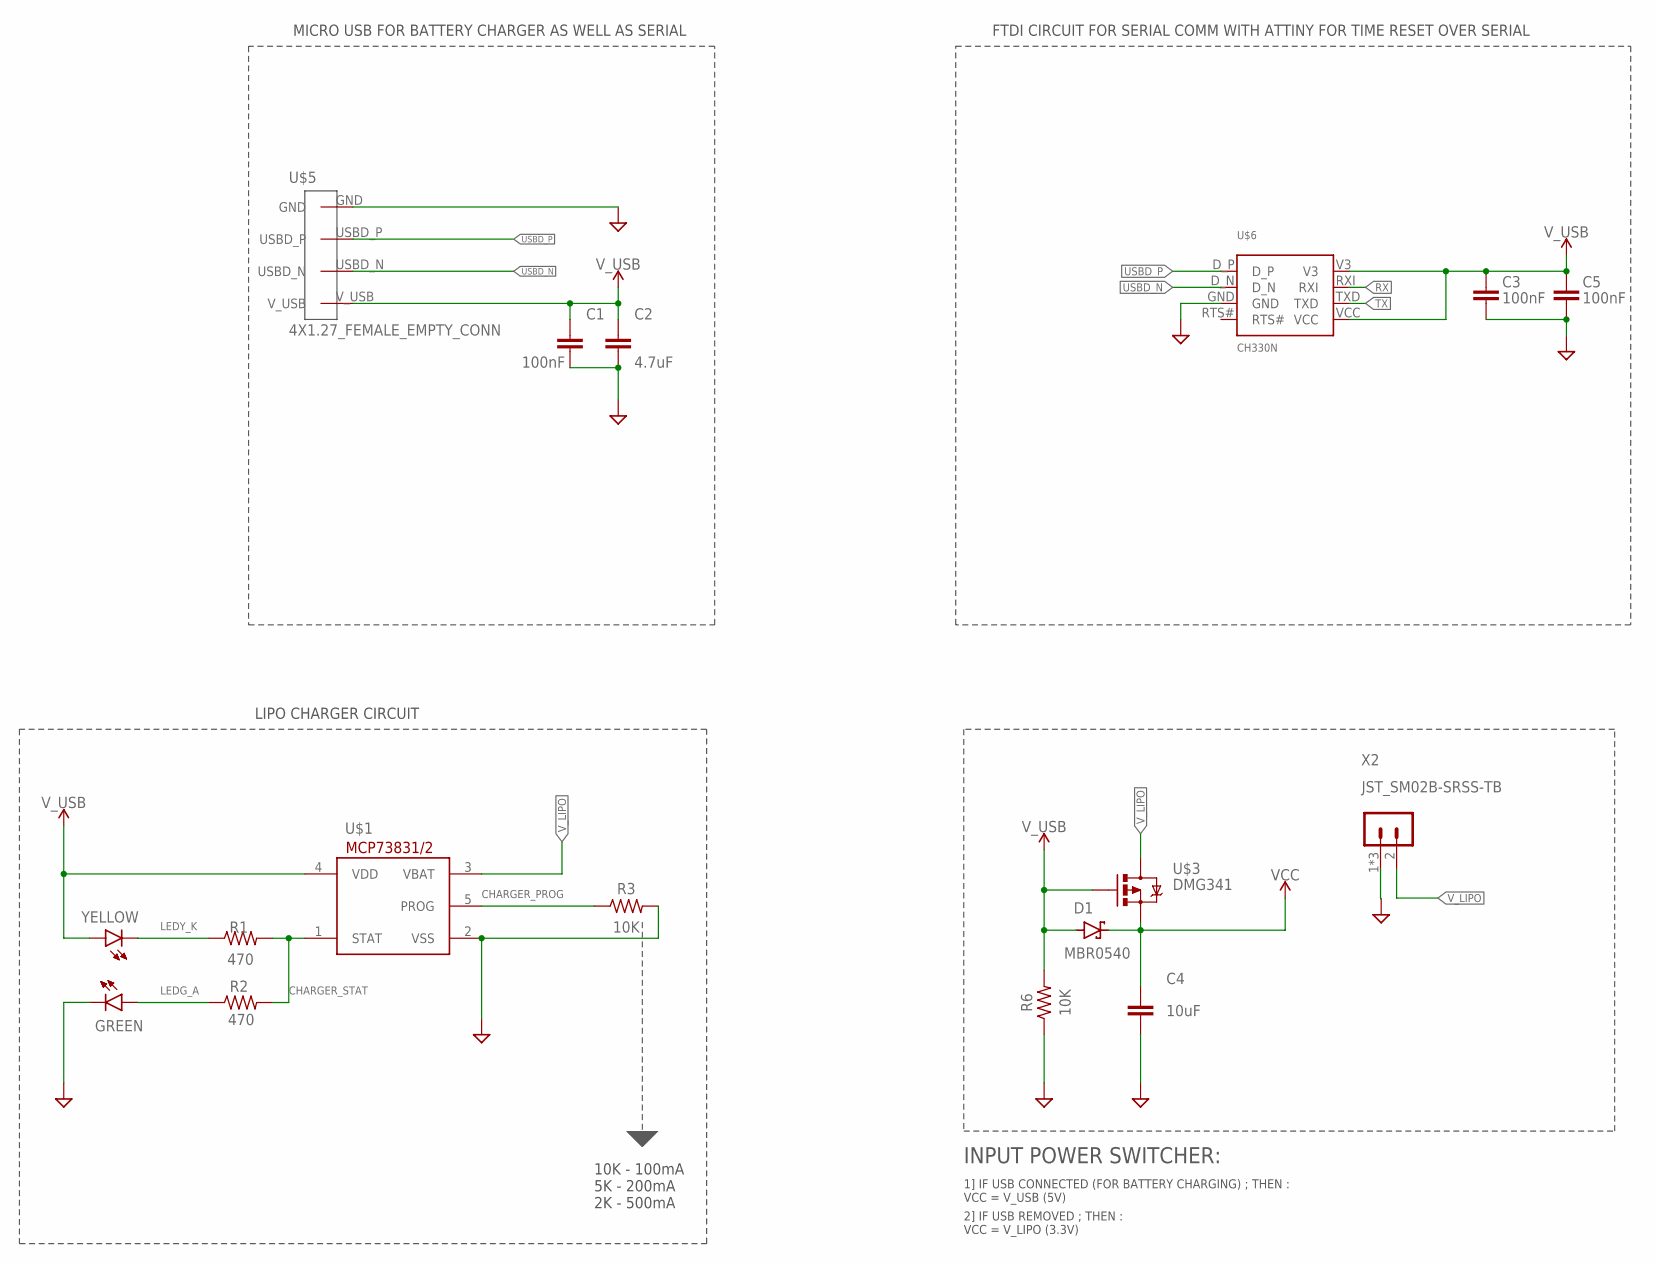
[picture p51: schematic watch_pcb.sch, sheet 1, FTDI Serial and Battery Charger]

Parts:
C1, C3, C5: 100nF; CAPC1005X60
C2: 4.7uF; CAPC1005X60
C4: 10uF; CAPC1005X60
D1: MBR0540; SOD-123
GREEN: GREEN; 2MMLED_GREEN
R1, R2: 470; RESC1005X40
R3, R6: 10K; RESC1005X40
U$1: MCP73831/2_LIPO_CHARGER; MCP73831_SOT23-5L
U$3: DMG341; DMG341-P_CHANNEL_MOSFET-SOT23
U$5: 4X1.27_FEMALE_EMPTY_CONN; 4X1.27_FEMALE_EMPTY_CONN-BACKUP
U$6: CH330N
X2: JST_SM02B-SRSS-TB; JST-SM02B-SRSS-TB
YELLOW: ORANGE; 2MMLED_YELLOW

Connections:
CHARGER_PROG: R3.1, U$1.5 (PROG)
CHARGER_STAT: R1.2, R2.2, U$1.1 (STAT)
GND: C1.2, C2.2, C3.2, C4.2, C5.2, GREEN.K (C), R3.2, R6.1, U$1.2 (VSS), U$5.GND, U$6.GND, X2.1, X2.M1 (1), X2.M2 (1); also elsewhere on the board
LEDG_A: GREEN.A, R2.1
LEDY_K: R1.1, YELLOW.K (C)
RX: U$6.RXI; also elsewhere on the board
TX: U$6.TXD; also elsewhere on the board
USBD_N: U$5.USBD_N, U$6.D_N
USBD_P: U$5.USBD_P, U$6.D_P
VCC: C4.1, D1.C, U$3.2 (S); also elsewhere on the board
V_LIPO: U$1.3 (VBAT), U$3.3 (D), X2.2; also elsewhere on the board
V_USB: C1.1, C2.1, C3.1, C5.1, D1.A, R6.2, U$1.4 (VDD), U$3.1 (G), U$5.V_USB, U$6.V3, U$6.VCC, YELLOW.A; also elsewhere on the board

Notes on the sheet:
10K - 100mA 5K - 200mA 2K - 500mA
FTDI CIRCUIT FOR SERIAL COMM WITH ATTINY FOR TIME RESET OVER SERIAL
MICRO USB FOR BATTERY CHARGER AS WELL AS SERIAL
LIPO CHARGER CIRCUIT
INPUT POWER SWITCHER:
1] IF USB CONNECTED (FOR BATTERY CHARGING) ; THEN : VCC = V_USB (5V)
2] IF USB REMOVED ; THEN : VCC = V_LIPO (3.3V)

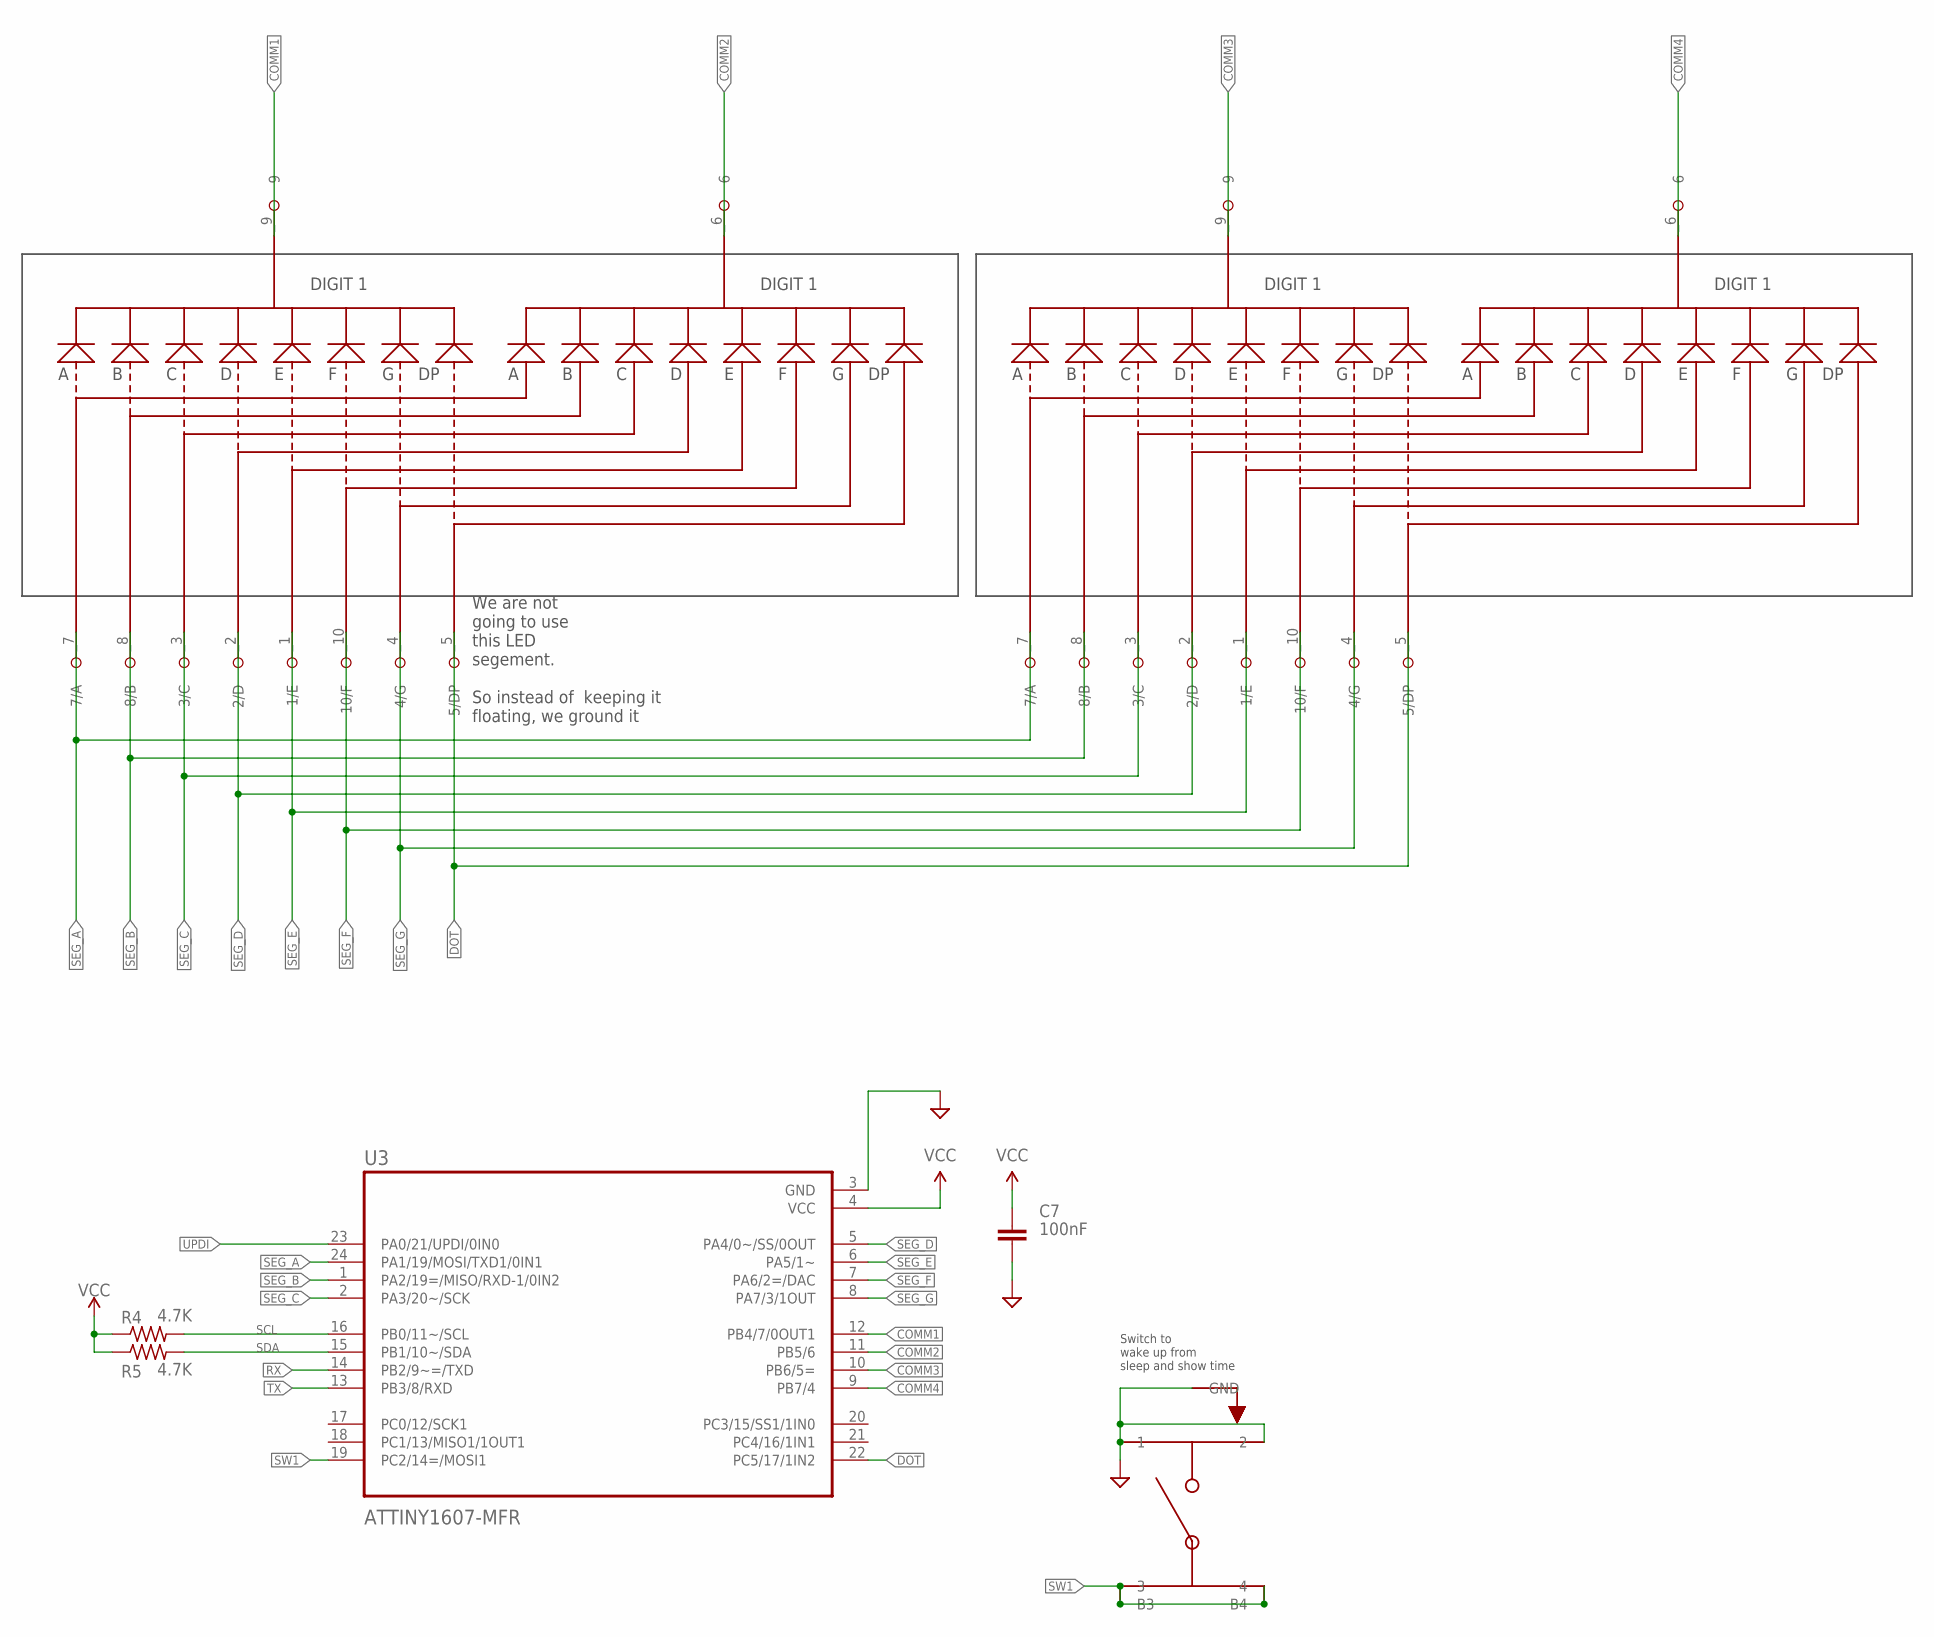
[picture p52: schematic watch_pcb.sch, sheet 2]

Parts:
BOT: 0.28-2DIGIT-7SEGEMNT; 2_DIGIT_0.28
C7: 100nF; CAPC1005X60
R4, R5: 4.7K; ADAFRUIT_R0402
TOP: 0.28-2DIGIT-7SEGEMNT; 2_DIGIT_0.28
U3: ATTINY1607-MFR; QFN50P400X400X90-25N
U$4: PTS840ESDPMSMTRLF

Connections:
COMM1: TOP._9 (9), U3.12 (PB4/7/0OUT1)
COMM2: TOP._6 (6), U3.11 (PB5/6)
COMM3: BOT._9 (9), U3.10 (PB6/5=)
COMM4: BOT._6 (6), U3.9 (PB7/4)
DOT: BOT._5 (5/DP), TOP._5 (5/DP), U3.22 (PC5/17/1IN2)
GND: C7.2, U3.3 (GND), U$4.1, U$4.2, U$4.5 (GND); also elsewhere on the board
RX: U3.14 (PB2/9~=/TXD); also elsewhere on the board
SCL: R4.2, U3.16 (PB0/11~/SCL); also elsewhere on the board
SDA: R5.2, U3.15 (PB1/10~/SDA); also elsewhere on the board
SEG_A: BOT._7 (7/A), TOP._7 (7/A), U3.24 (PA1/19/MOSI/TXD1/0IN1)
SEG_B: BOT._8 (8/B), TOP._8 (8/B), U3.1 (PA2/19=/MISO/RXD-1/0IN2)
SEG_C: BOT._3 (3/C), TOP._3 (3/C), U3.2 (PA3/20~/SCK)
SEG_D: BOT._2 (2/D), TOP._2 (2/D), U3.5 (PA4/0~/SS/0OUT)
SEG_E: BOT._1 (1/E), TOP._1 (1/E), U3.6 (PA5/1~)
SEG_F: BOT._10 (10/F), TOP._10 (10/F), U3.7 (PA6/2=/DAC)
SEG_G: BOT._4 (4/G), TOP._4 (4/G), U3.8 (PA7/3/1OUT)
SW1: U3.19 (PC2/14=/MOSI1), U$4.3, U$4.4, U$4.B3, U$4.B4
TX: U3.13 (PB3/8/RXD); also elsewhere on the board
UPDI: U3.23 (PA0/21/UPDI/0IN0); also elsewhere on the board
VCC: C7.1, R4.1, R5.1, U3.4 (VCC); also elsewhere on the board

Notes on the sheet:
Switch to wake up from sleep and show time
We are not going to use this LED segement. So instead of keeping it floating, we ground it

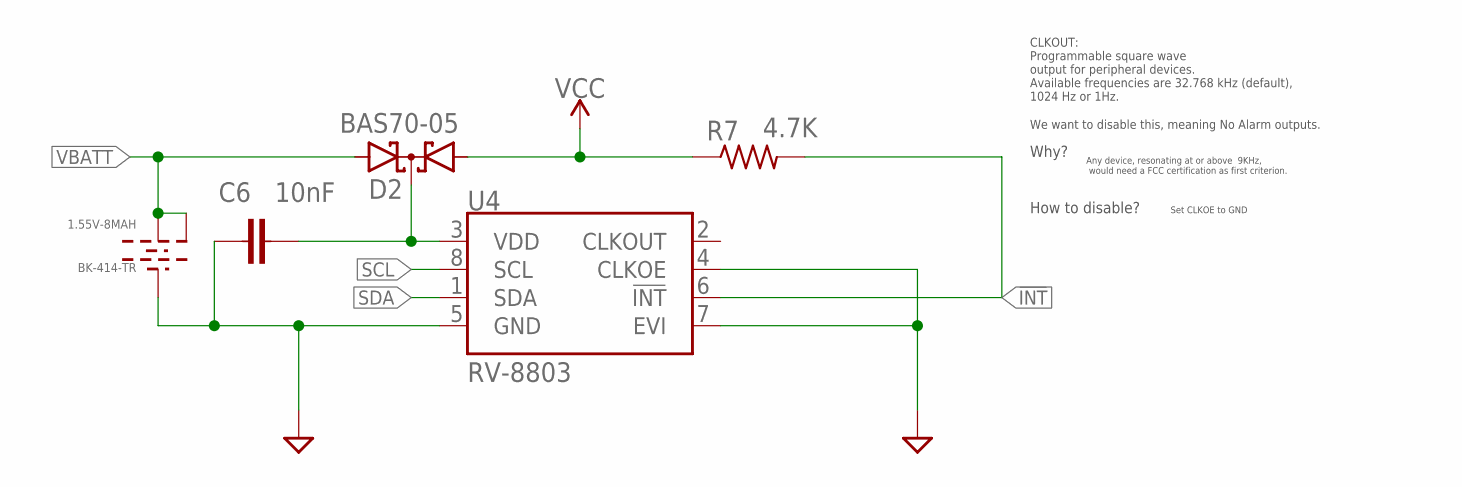
[picture p53: schematic watch_pcb.sch, sheet 3, RV8803 RTC]

Parts:
1.55V-8MAH: BK-414-TR
C6: 10nF; 0402-TIGHT
D2: BAS70-05; SOT23
R7: 4.7K; ADAFRUIT_R0402
U4: RV-8803; RV-3028

Connections:
!INT: R7.2, U4.6 (!INT)
GND: 1.55V-8MAH.- (_GND), C6.2, U4.4 (CLKOE), U4.5 (GND), U4.7 (EVI); also elsewhere on the board
SCL: U4.8 (SCL); also elsewhere on the board
SDA: U4.1 (SDA); also elsewhere on the board
VBATT: 1.55V-8MAH.1+ (VOUT), 1.55V-8MAH.2+ (VOUT2), D2.2 (A2)
VCC: D2.1 (A1), R7.1; also elsewhere on the board
VDD1: C6.1, D2.3 (C), U4.3 (VDD)

Notes on the sheet:
CLKOUT: Programmable square wave output for peripheral devices. Available frequencies are 32.768 kHz (default), 1024 Hz or 1Hz.
We want to disable this, meaning No Alarm outputs.
Why?
How to disable?
Set CLKOE to GND
Any device, resonating at or above 9KHz, would need a FCC certification as first criterion.

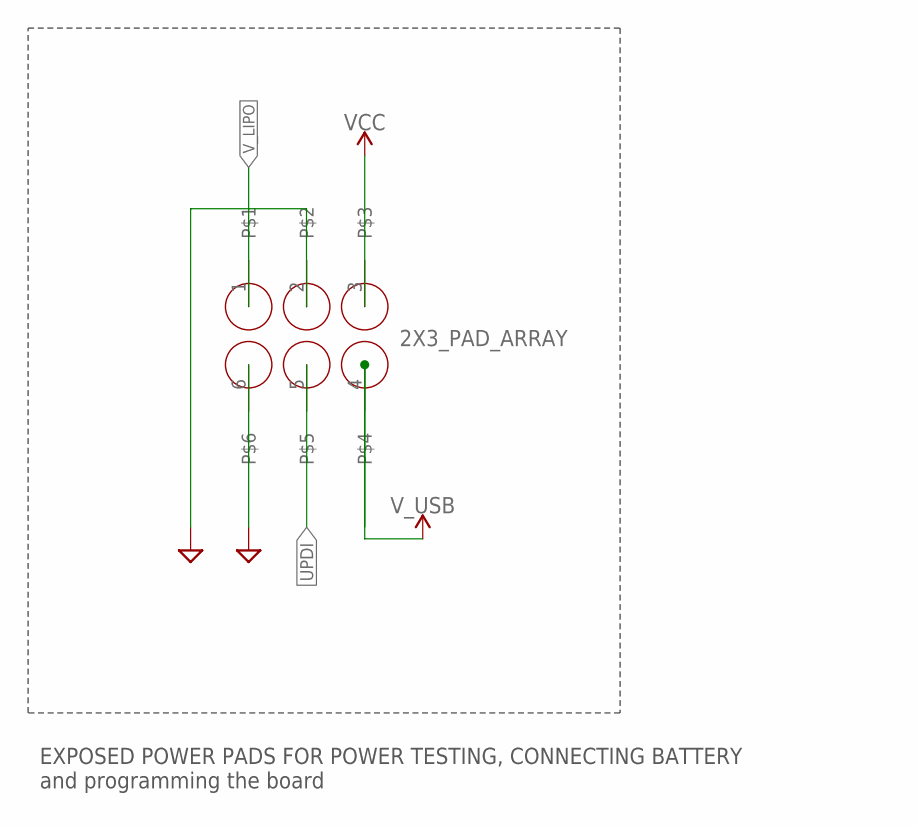
[picture p54: schematic watch_pcb.sch, sheet 4]

Parts:
U$2: 2X3_PAD_ARRAY

Connections:
GND: U$2.2, U$2.6; also elsewhere on the board
UPDI: U$2.5; also elsewhere on the board
VCC: U$2.3; also elsewhere on the board
V_LIPO: U$2.1; also elsewhere on the board
V_USB: U$2.4; also elsewhere on the board

Notes on the sheet:
EXPOSED POWER PADS FOR POWER TESTING, CONNECTING BATTERY and programming the board

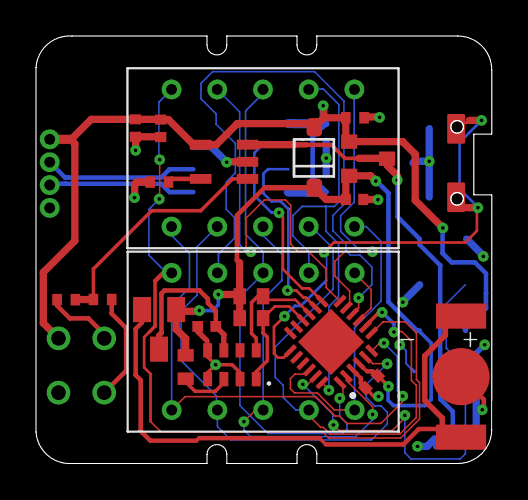
[picture p55: board watch_pcb.brd from above]

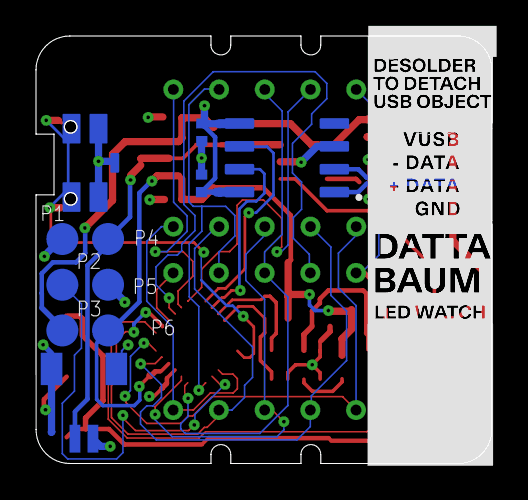
[picture p56: board watch_pcb.brd from below]

Board: 4 copper layers, 25.3 x 23.7 mm, 30 parts (6 on the bottom side), 31 nets.
