devATdbsutdio/watch_hardwares/(commit log)

2022-04-21 added watch pcb gerber files
2022-04-21 added exported pcb files from f3d for user prog jig
    [user_prog_jig_pcb v16.step]
2022-04-22 some folder arrangements and added GERBER exports
    [HOR_water_tight_microUSB_raiser.brd, HOR_water_tight_microUSB_raiser.f3d, HOR_water_tight_microUSB_raiser.sch, HOR_water_tight_microUSB_raiser.step, user_prog_pcb v42.sch, user_prog_pcb v67.brd, user_prog_pcb.step, watch_pcb.brd]
2022-05-25 long time no see
    [user_prog_jig_pcb v64.sch, user_prog_jig_pcb_v206.brd, user_prog_pcb v42.sch, user_prog_pcb v67.brd, user_prog_pcb_shell.f3d, user_prog_pcb_shell.step]
2022-05-26 watch pcb verison name change in folder
    [box in foam 350x300x130.dxf, foam PCB tray.dxf, watch_pcb.brd, watch_pcb.sch]
2022-05-26 added BOM for watch
    [THV3_BOM.xlsx]
2022-05-26 added PnP an folder restructre in watchpcb DIR
    [watch_pcb.brd, watch_pcb.sch]
2022-05-26 added component testing jig DIR
    [jig_version_2 v87.csv, testing_jig.brd, testing_jig.sch, testing_jig_PCB.f3z, testing_jig_assembly.f3z]
2022-06-01 new jig modification exports
    [BottmTopFrame v2.f3d, LockHinge v2.f3d, LockHinge v2.step, TopFrame v2.step]
2022-06-04 new user programmer micro usb replacement
    [HOUSING.f3d, HOUSING.step, user_prog_jig_pcb v64.csv, user_programmer v11.csv, user_programmer v11.xlsx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]
2022-06-10 micro usb version slim shell added
    [micro_usb_version_prog_shell.f3d, micro_usb_version_prog_shell.step]
